ajodutola/FuelCellMonitorTeam-ECEN403/All_Russ_Docs/PCB Design.jpg

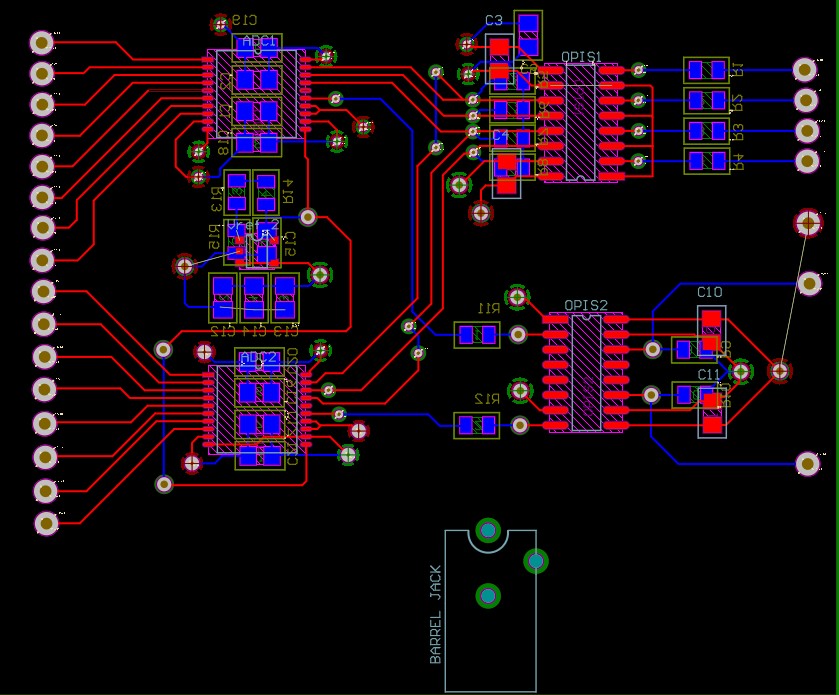
All_Russ_Docs/PCB Design.jpg
