ajodutola/FuelCellMonitorTeam-ECEN403/All_Russ_Docs/High Level Subsystem Schematic.jpg

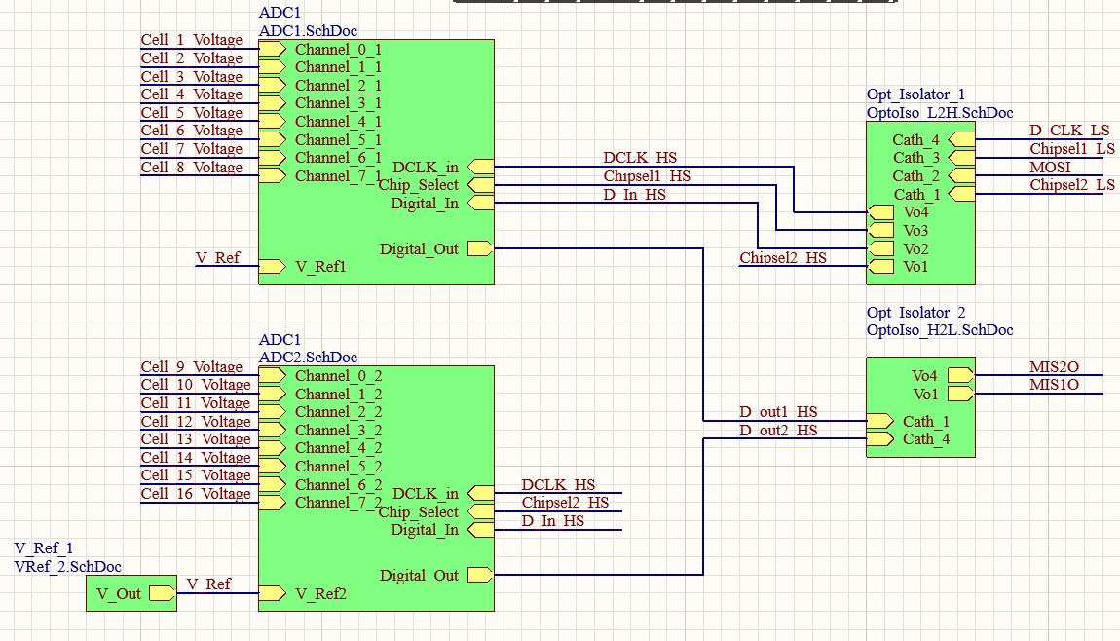
All_Russ_Docs/High Level Subsystem Schematic.jpg
