ajodutola/FuelCellMonitorTeam-ECEN403/All_Russ_Docs/Max into Processor is 14mA.docx

Max into Processor is 14mA.

Max input Voltage 5V.
