ajodutola/FuelCellMonitorTeam-ECEN403/Status Update 5-1.pdf

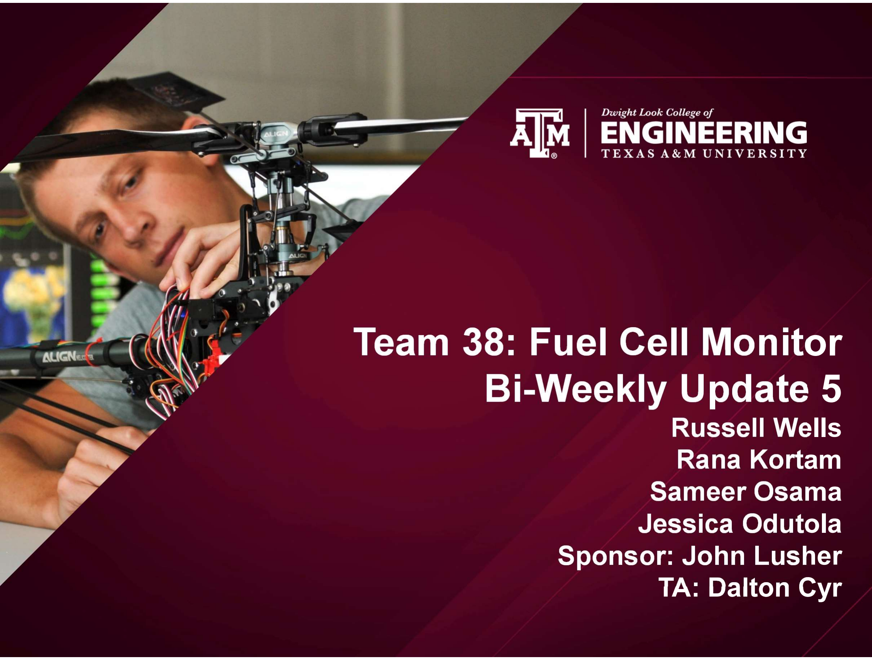
[picture p58: page 1]

# Team 38: Fuel Cell Monitor Bi-Weekly Update 5

### Russell Wells Rana Kortam Sameer Osama Jessica Odutola Sponsor: John Lusher TA: Dalton Cyr

# Project Summary

- Problem statement: A single fuel cell is an easy power source to monitor, but to achieve any level of real usable power

they must be connected in a stack. If only monitored as a whole, each cell would have to be tested individually to determine the issue. This causes longer down times and more technician wages


to trouble shoot.
- The Fuel Cell Monitor System will give the operator real time voltages of both the individual cells and stack. The voltages will be monitorable from an android based mobile app. In case of over or under voltage, the app will notify

the operator of not only the error but which cell has fallen or risen outside of expected ranges. Saving both time and money for repairs.

## Fuel Cell Monitor Integrated System Diagram

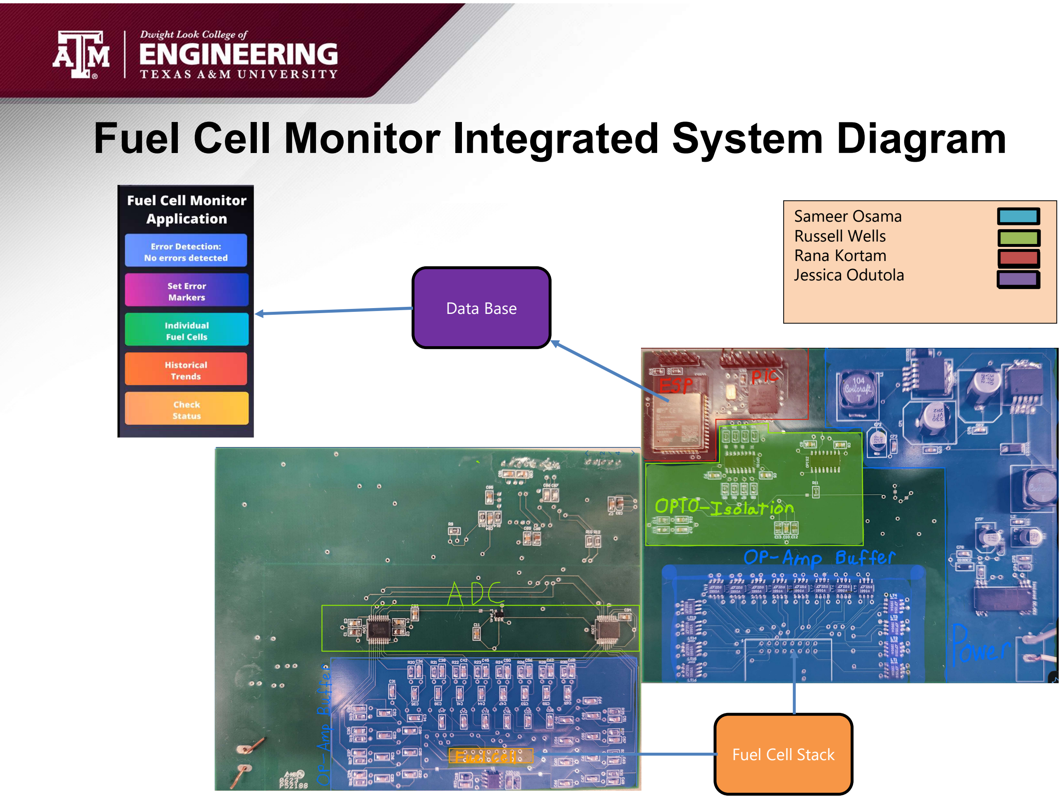
[picture p59: page 3]

Sameer Osama
Russell Wells
Rana Kortam
Jessica Odutola

Fuel Cell Stack

Data Base

# Project Timeline

Finalize Subsystems [Late January]

Power system issue resolved,
Burnt out Op-Amp was the
issues. SPI communication
validated.

PIC is not manipulating chip
select for each device. The
ADC’s do not recognize the
data being transmitted to
them.

Validate PCB and
start assembly
[February]

Debug and Integrate
[late February and
March]

Validation
[mid February through
late March]

Final Demo [late April]

Board is soldered and
ESP/PIC32 have been
successfully flashed.

# Sameer Osama

Accomplishments since Update | Ongoing progress/problems and plans until the next presentation
- N/A | handle twice the maximum voltage - Testing negative differential in buffer system
4 | 8 hrs of effort | - Ongoing: Testing if device can

-DC/DC converters output correct voltages from 0A – 1A
-Isolated DC/DC converter max current it can handle is .15A while still outputting the voltage required.

E-load measurements:

# Sameer Osama


# Russ Wells

Accomplishments since Update 4 11 Hours Worked | Ongoing progress/problems and plans until the next presentation
Validated Full Voltage Range. | Ongoing: -- Validating ADC operations. -- Update PCB Design as needed.

# Rana Kortam

Ongoing progress/problems and plans until the next presentation

Accomplishments since update 4

### 15 hrs of effort

Ongoing: Integrating with ADC; Clock and digital in pin are working correctly and were able to read voltage values from the Digital out pin. The Chip select doesn't work properly.
Future: Complete Integration with ADC and Database

Validating Full Voltage Range with Russ.

# Rana Kortam and Russ Wells

ADC voltage readings from cells

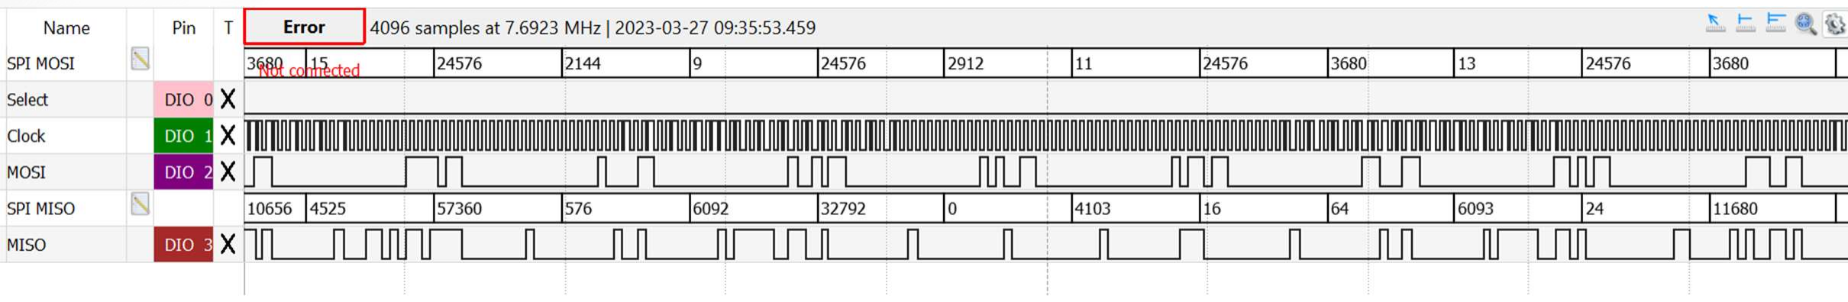
[picture p60: figure]

# Rana Kortam and Russ Wells

ADC voltage readings from cells

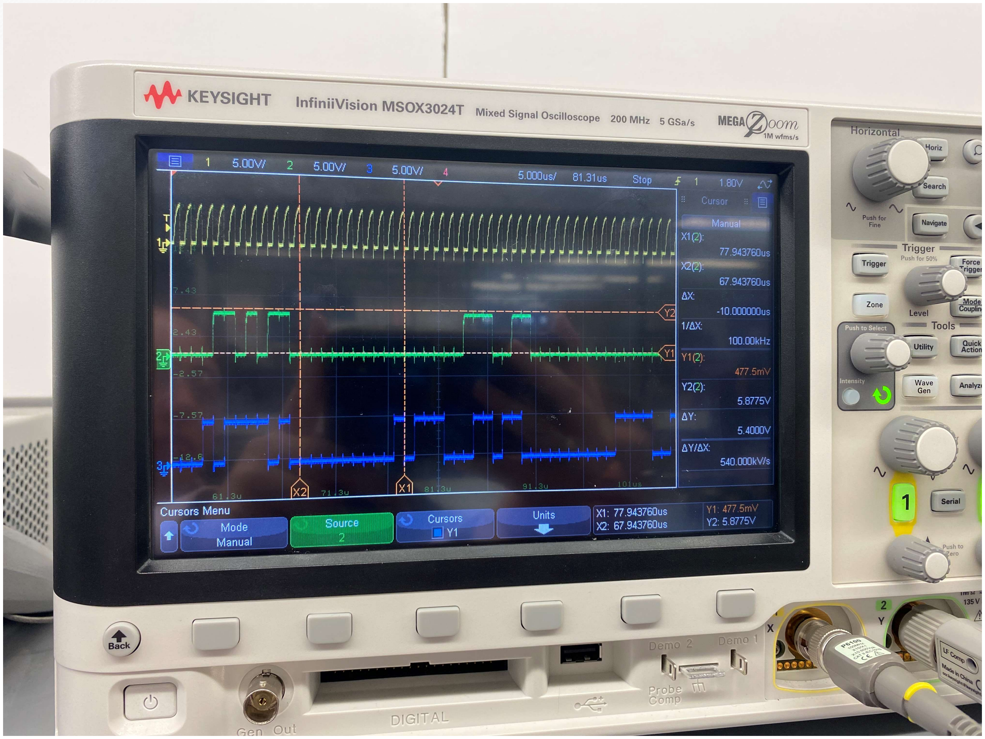
[picture p61: figure]

# Jessica Odutola

Accomplishments since update 4 | Ongoing progress/problems and plans until the next presentation
N/A | edge cases for App Subsystem - Future: Complete integration and validate integrated system
10 hrs of effort | - Ongoing: Integration with MCU; - Ongoing: Testing and validating

# Jessica Odutola

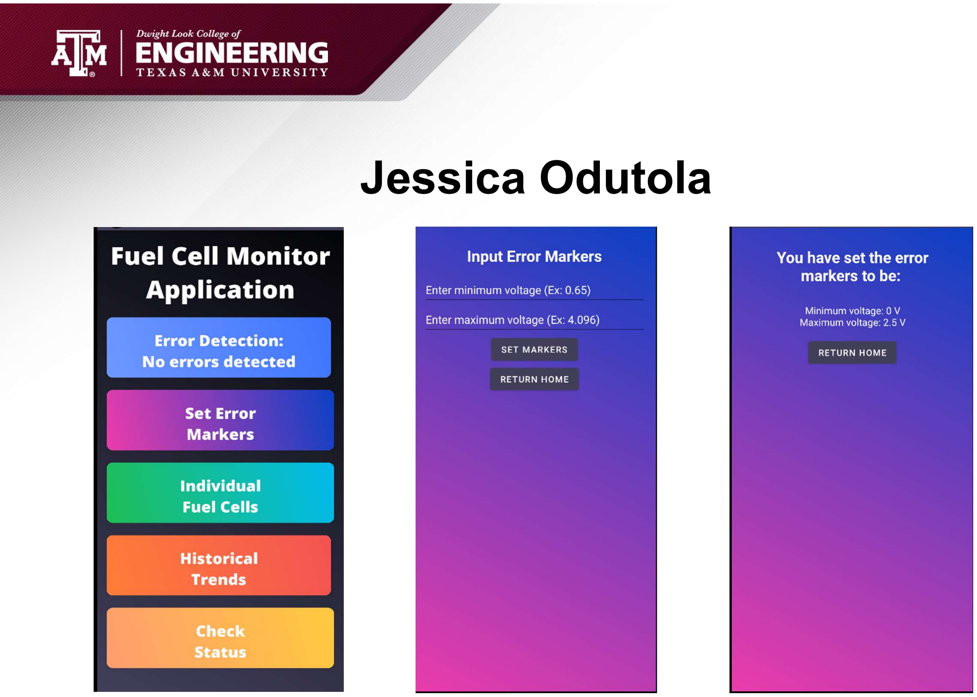
[picture p62: page 12]

## Execution Plan

| 1/17/2023 | 1/24/2023 | 1/31/2023 | 2/7/2023 | 2/14/2023 | 2/21/2023 | 2/28/2023 | 3/7/2023 | 3/14/2023 | 3/21/2023 | 3/28/2023 | 4/4/2023 | 4/11/2023 | 4/18/2023 | 4/25/2023 | DATE
TEAM DELIVERABLES
Solder and Test Power | | | | | | | | | | | | | | | | Completed
Solder and Test Signal Transfer | | | | | | | | | | | | | | | | In Progress
Solder and Test Micro Controllers | | | | | | | | | | | | | | | | Not Started
PCB/System redesign and order for Test Problems and Pactec Enclosure | | | | | | | | | | | | | | | | Behind Schedule

Full System Assembly and Testing
POWER SUBSYSTEM
Troubleshoot system
Order extra parts if need be INTERNAL SIGNAL SUBSYSTEM
Integrated PCB Design
Order Integrated PCB
MICRO CONTROLLER SUBSYSTEM
SPI communication with ADC
Review SPI communication with Dr. Lusher Integrate SPI with ADC
Order for Test Problems
APP SUBSYSTEM
App Reads Values from Database Integration with Microcontroller Full System Assembly and Testing

## Validation Plan

| Test Name | Success Criteria | Methodology | Status | Responsible Engineer(s) | Notes Paragraph #
| Mass | Mass of the fuel cell monitor shall be less than or equal to 0.25 kilograms 3.1.1.1 | scale | Untested | Rana Measure the fuel cell monitor with digital | Cells were tested at
| Read full voltage Range | voltages to the database from 0 to 4.096 V 3.2.1.1 | Apply sustained negative voltage | Passed | Russell Device is capable of measuring and passing | 0V, 1V, 2V, and 4.096V and 5Volts.
3.2.4.2 Discontinuous cell | | Device is capable of handling up to twice the maximum measurable voltage input without damage to system | a single cell input and check functionality. | Untested | Sameer Apply voltages at least 8.192 Volts across
| General Error Alerts | App is able to correctly indicate which fuel cell is Low/High and Alerts the User of the situation Via the App. 4.3.1 | scale | Untested | Jessica Measure the fuel cell monitor with digital
| User Specified Error Markers | App is capable of successfully changing the criteria for alerts 4.3.2 | voltage range, apply a voltage outside of the range to one of the cells and monitor the app for the error alert. | Untested | Jessica Use the app the manipulate the fuel cell
| Power Outage Restart | Device should power up, reboot, and continue operation after full power disconnect 5.1.1.1 | (Allow capacitors to dissipate) and reconnect power. | Untested | Rana Disconnect power source for 30 seconds
| System Loop Functionality | by the device, reported to the database, and displayed on the app. 5.1.1.1 | both the database and is displayed on the app. A voltage is applied to the fuel cell input, read cell input and ensure the data appears in | Untested | Rana Apply a voltage of 2.048 volts to the first

# Thank you! Any questions?
