ajodutola/FuelCellMonitorTeam-ECEN403/All_Russ_Docs/Final Presentation PDF.pdf

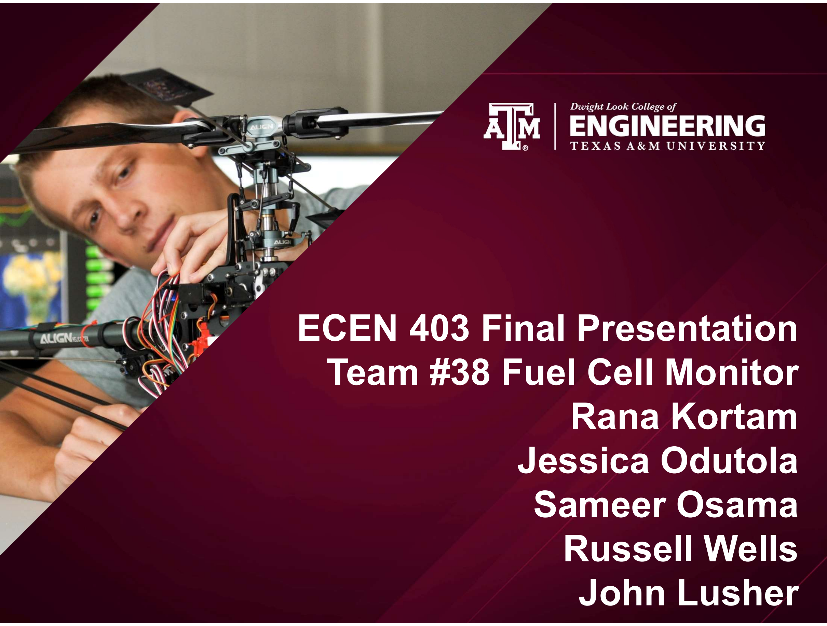
[picture p78: page 1]

# ECEN 403 Final Presentation Team #38 Fuel Cell Monitor Rana Kortam Jessica Odutola Sameer Osama Russell Wells John Lusher

# Project description

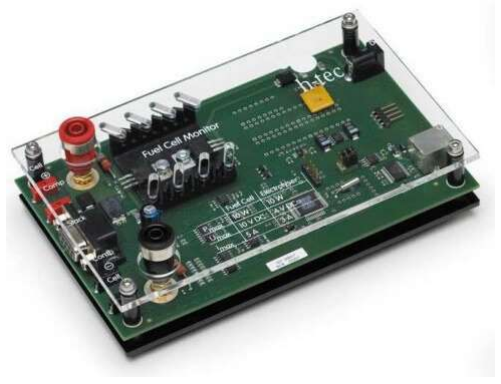
[picture p79: figure]

- Problem statement: A single fuel cell is an easy power source to monitor, but to achieve any level of real usable power they must be connected in a stack. The goal of this project is to design a monitor that displays individual cell voltages within a stack and warns the user of cell abnormalities as well as which cell

requires maintenance or attention.

# Diagram of subsystems and interface

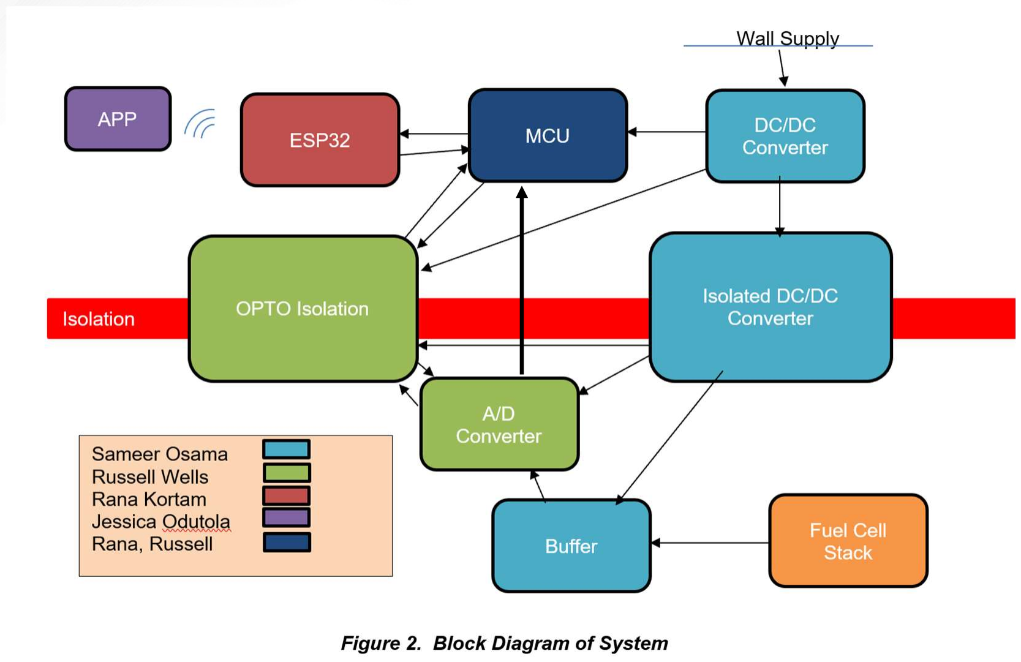
[picture p80: figure]

# 403 Deliverables (Power Supply)

# - Design PCB in Altium - Order PCB and solder components - Test output voltages

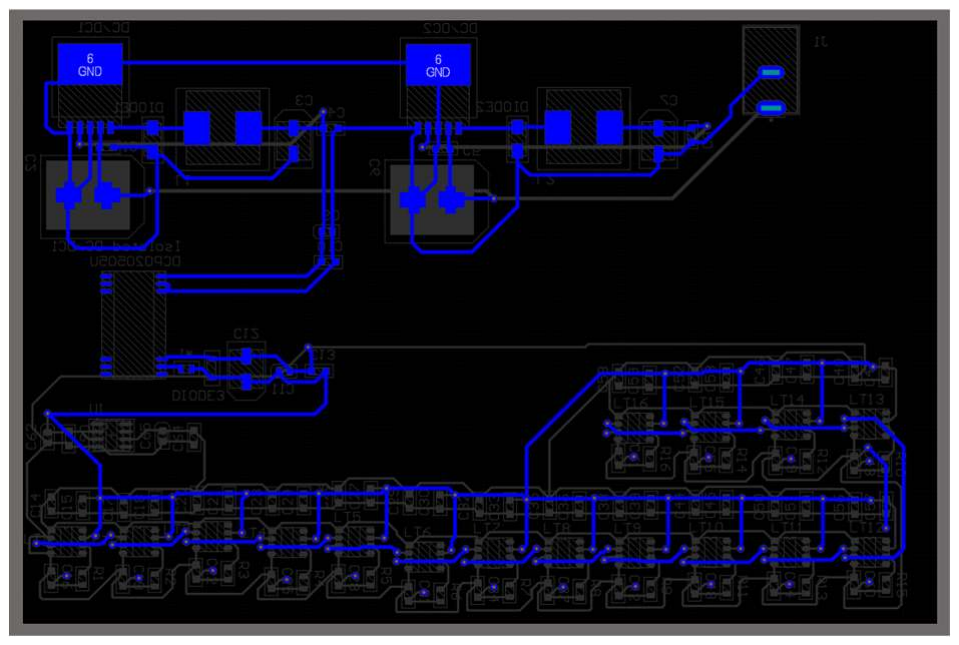
[picture p81: figure]
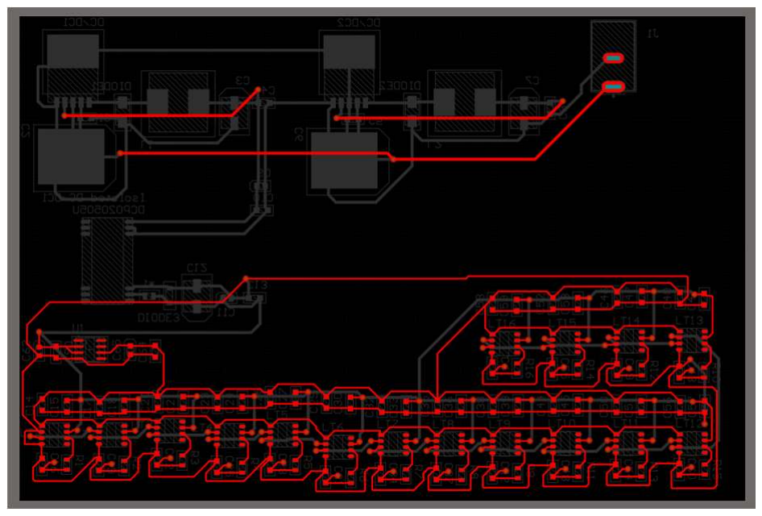
[picture p82: figure]

Top Layer | Bottom Layer

# Challenges (Power Supply)

# - Learning how to make schematics and footprints - Using a new software (Altium) - Figuring out what specific parts to order

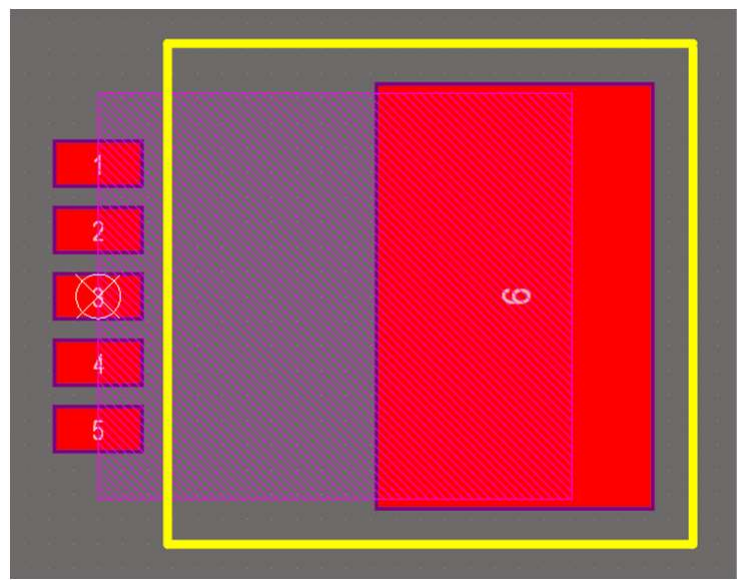
[picture p83: figure]
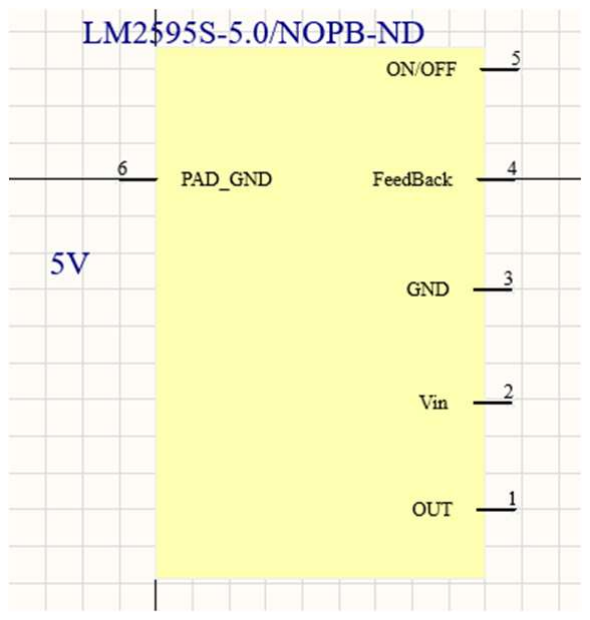
[picture p84: figure]

- Create PCB Design.

# - Create Breadboard Test Circuit

- Confirm Isolator Circuit’s Ability To Pass Digital Information. Confirm Isolator Circuit’s Ability to Control ADC.

# Internal Data Transfer and Manipulation Deliverables

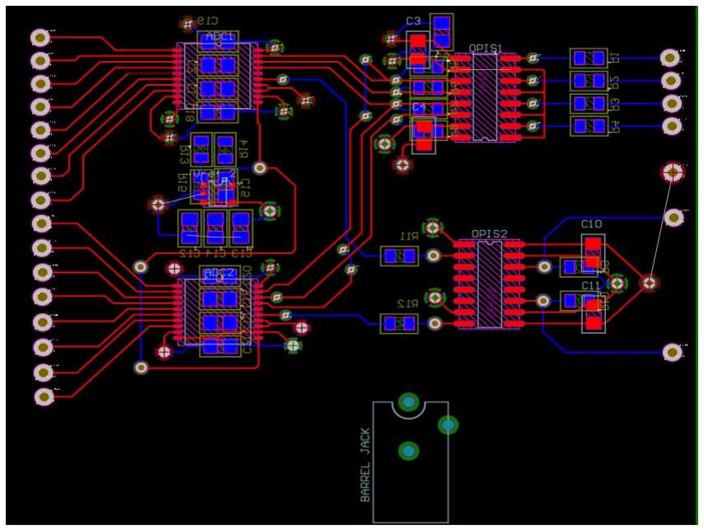
[picture p85: figure]

# CHALLENGES 1. Isolator Distorts Digital Signal 2. Switching Speed of isolator is much lower than anticipated 3. Learning To code with Arduino and use SPI

Library.

# SOLUTIONS 1. Reduce Clock Frequency from 2MHz to 125kHz (Ongoing) 2. Same solution as 1 but the frequency is slightly higher than 1/24th the capability of

the ADC.

# 3. Continuing to learn from

Arduino website and forums.

# Internal Data Transfer and Manipulation

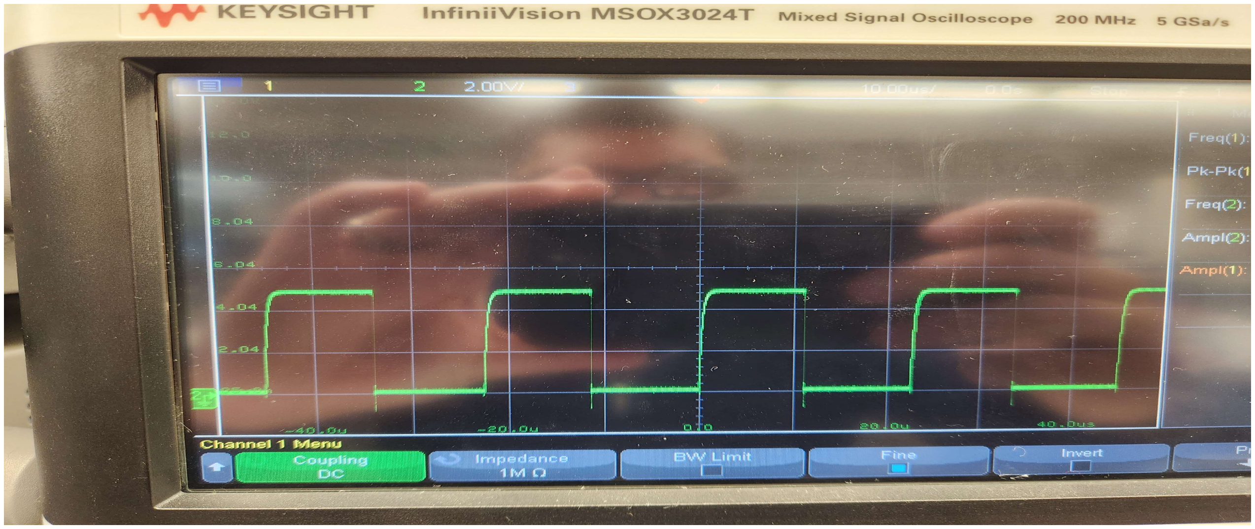
[picture p86: figure]

# ESP32

# 403 Deliverables

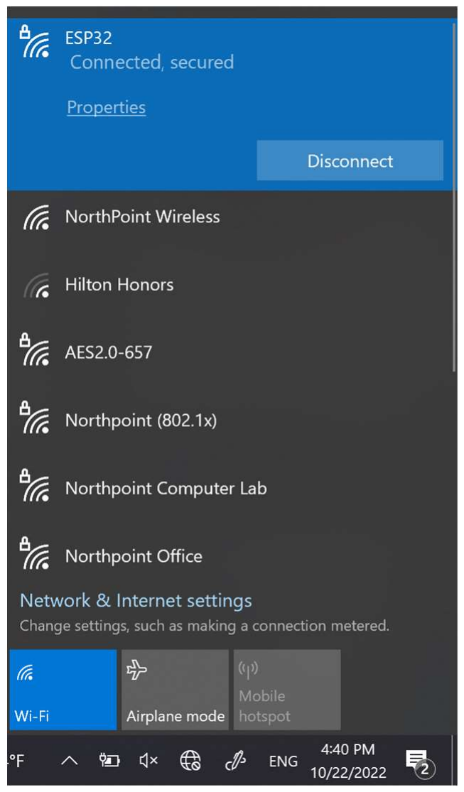
[picture p87: figure]

# - ESP32 to connect to WiFi - UART communication for ESP32 - Connect ESP32 to database Challenges - Learning the ESP-IDE - Connection to database

# ESP32

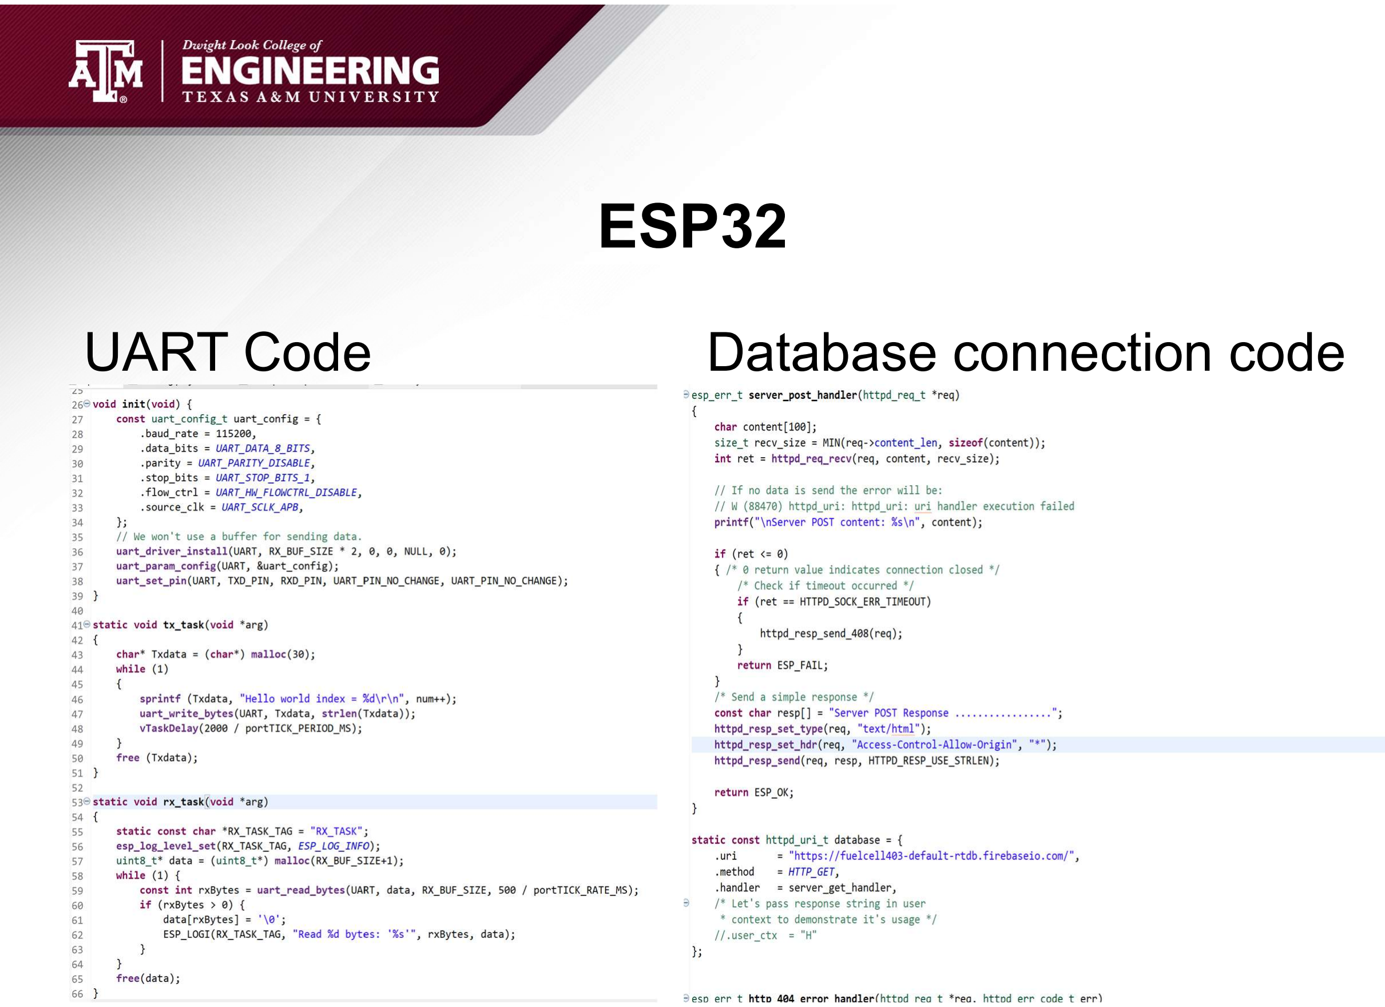
[picture p88: page 9]

UART Code | Database connection code

# PIC32

# 403 Deliverables

# - UART communication - A/D converter code - Array of fuel-cell voltages Challenges - Learning MPLAB IDE - Fried the PIC32 chip

# PIC32

AD Converter Code | UART Code

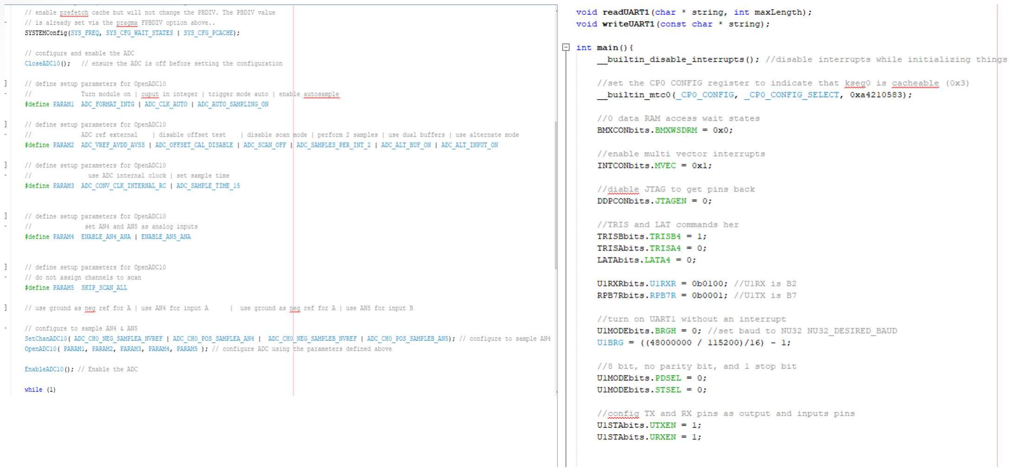
[picture p89: figure]

# Android Application

# 403 Deliverables - Complete Layout of Android Application - Database Storage and Connection to App - Alert functionality for user Challenges - Database Connection

# Android Application

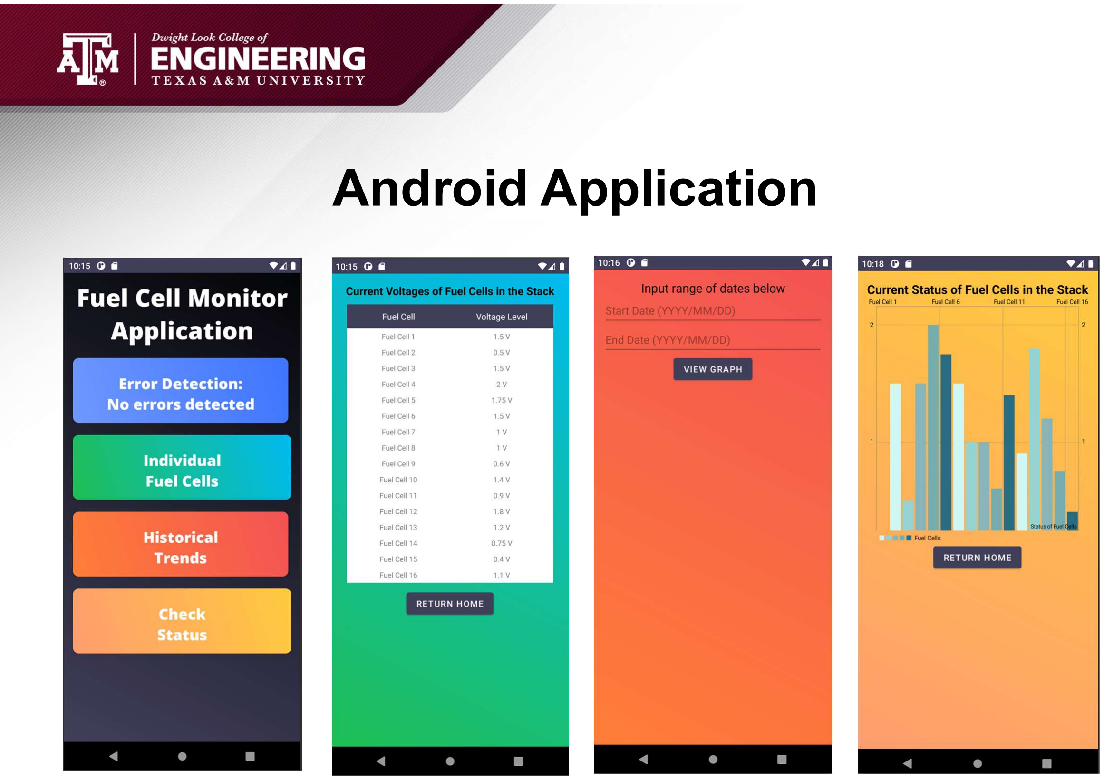
[picture p90: page 13]

# Execution and Validation Status

9/5/2022 | 9/12/2022 | 9/19/2022 | 9/26/2022 | 10/3/2022 | 10/10/2022 | 10/17/2022 | 10/24/2022 | 10/31/2022 | 11/7/2022 | 11/14/2022 | 11/21/2022 | 11/28/2022 | DATE TEAM DELIVERABLES Understand Project Problem
Project design Overview | Completed Divide Into Subsystems | In Progress ConOps Report | Not Started Create Major Parts List | Behind Schedule

FSR, ICD Report Midterm Presentation Order Major Parts

Status Update Presentation Final Presentation
Final Demo
Final Report POWER SUBSYSTEM

Determine IC Components
Design Schematics
Order IC components
Create PCB footprints in Altium Create PCB design in Altium Make Gerber files and send to FEDC Test components on circuit board INTERNAL SIGNAL SUBSYSTEM
Determine IC Components
Design System
Order Components Create PCB Schematic Assemble and Test Demo Create PCB Design Order PCB MICRO CONTROLLER SUBSYSTEM

Determine Microcontrollers in use Learn IDE to code microcontroller Implement "Hello World" on ESP32 WiFi connection on ESP32 UART on ESP32 UART on PIC32 Array code for PIC32 AD Converter code Connect ESP32 to database APP SUBSYSTEM

App Displays "Hello World" App Displays Home Page
App Displays all pages needed AWS Database Created

Tables Populated in Database Connect Database to App
App Sends Alerts to Users
App Works with Test Data WiFi Connection with Microcontroller

# Execution and Validation Status

Paragraph # | Test Name | Success Criteria | Methodology | Status | Responsible Engineer(s)
3.2.4.2 | Power Devices On PCB | PCB transfers power without overheating or burnout | Power Board and watch, smell, listen | Untested | Russell, Sameer
3.2.1.1 | Internal signal voltage range | System can properly handle the specified voltages with minimal difference between tests. | Introduce voltages of 0-4V and measure output signals | FAIL | Russell
3.2.1.1 | Differential voltage tests | Pass a differential voltage through the Opamp buffer and receive the proper digital signal from the optoisolator | Introduce a range of voltages including edge cases and ensure proper output | Untested | Russell, Sameer
3.2.4.4 | Android application graphical functionality | Application can properly display accurate voltage levels to user. | Use application on android device and verify volatages are accurately displayed | Tested | Jessica
3.2.4.4 | Android Application alarm functionality | Application send alarm to user when voltage goes above or below ranges | Add set points to app and introduce alarm level voltages | Untested | Jessica
3.2.4.2 | Power system functionality test | Power is applied from wall outlet and proper power transfer is read at outputs | Apply power to system and read voltage output at device trace | Untested | Sameer
3.2.4.1 | Opamp system functionality test | Differential voltages are passed to the opamp and expected voltage is seen on the output | Power opamps and apply varrying differential voltages and read output voltage | Untested | Sameer
N/A | PIC32 Microcontroller functionality test | The code for recieving the voltage signal for data acquisition | PCB board and coding on IDE | In progress | Rana
N/A | ESP32 Microcontroller functionality test | The code for communicating with the application | PCB board and coding on IDE | Tested | Rana

# Remaining Tasks

# - Complete testing of internal signal system - Complete Microcontroller/processor PCB design - Integrate All subsystems onto a single

PCB.

# - Final Testing and Validation of Completed

Internal System.

# - Purchase system enclosure and

assemble.
