ajodutola/FuelCellMonitorTeam-ECEN403/All_Russ_Docs/Update Presentation.pptx

Team: Project Title

Needs Analysis Problem Statement Design Proposal | Subsystem Development - Prototype

System Block Diagram and description

## Project name: Fuel Cell Monitor Team members: Rana Kortam Jessica Odutola Sameer Osama Russell Wells Sponsor: John Lusher

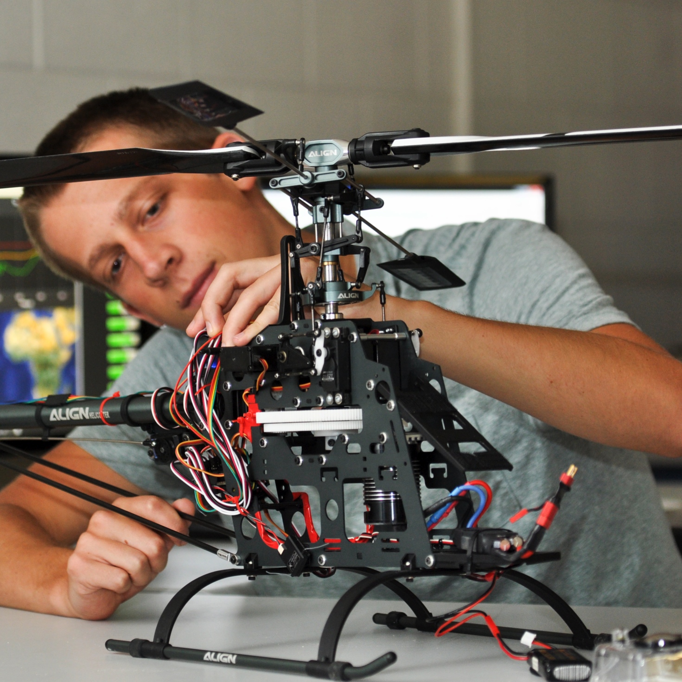
[picture p108: figure]

## Slide 3

Team: Project Title

Copy of your schedule with identification of what is completed vs pending

## Slide 4

<Subsystem(s)> Team Member1

Accomplishments since the last presentation <XX> hrs | Ongoing progress/problems and plans until the next presentation

Subsystem Picture, Sketch or Graph (1 per team member)

## Slide 5

<Internal Signal Transfer and Manipulation Subsystem> Team Member2

Accomplishments since the last presentation <30> hrs | Ongoing progress/problems and plans until the next presentation
Subsystem design is complete and has been successfully simulated All subsystem components have been ordered.

Subsystem Picture, Sketch or Graph (1 per team member)

## Slide 6

<Subsystem(s)> Team Member3

Accomplishments since the last presentation <XX> hrs | Ongoing progress/problems and plans until the next presentation

Subsystem Picture, Sketch or Graph (1 per team member)

## Slide 7

<Subsystem(s)> Team Member4

Accomplishments since the last presentation <XX> hrs | Ongoing progress/problems and plans until the next presentation

Subsystem Picture, Sketch or Graph (1 per team member)
