ajodutola/FuelCellMonitorTeam-ECEN403/All_Russ_Docs/20221130_115714.jpg

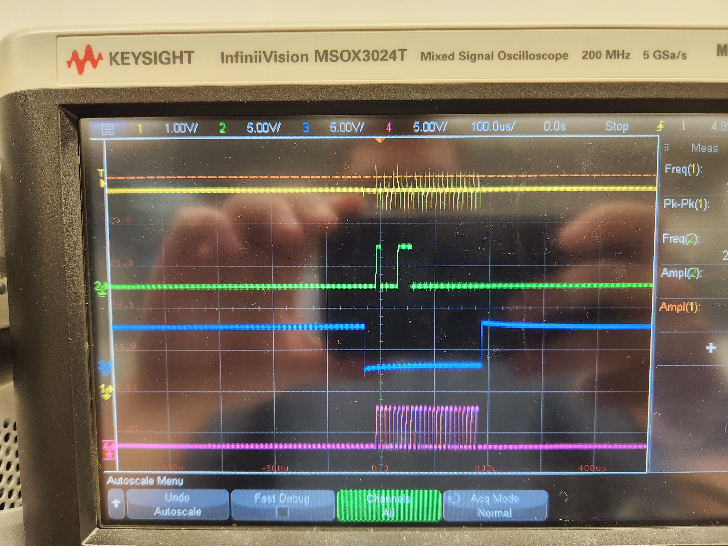
All_Russ_Docs/20221130_115714.jpg
