ajodutola/FuelCellMonitorTeam-ECEN403/All_Russ_Docs/ADC screen shot.jpg

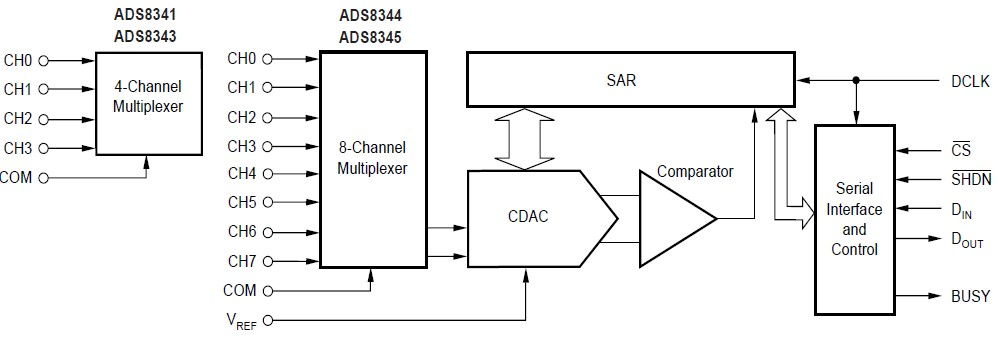
All_Russ_Docs/ADC screen shot.jpg
