ajodutola/FuelCellMonitorTeam-ECEN403/All_Russ_Docs/ADC's.jpg

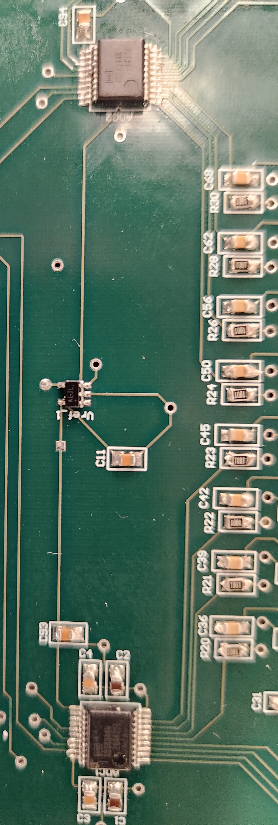
All_Russ_Docs/ADC's.jpg
