ajodutola/FuelCellMonitorTeam-ECEN403/All_Russ_Docs/Board Pic.png

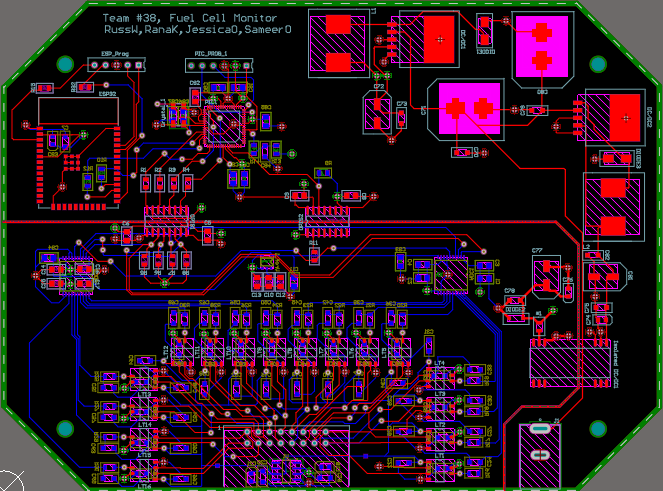
All_Russ_Docs/Board Pic.png
