ajodutola/FuelCellMonitorTeam-ECEN403/All_Russ_Docs/ESP WIFI Connected.jpg

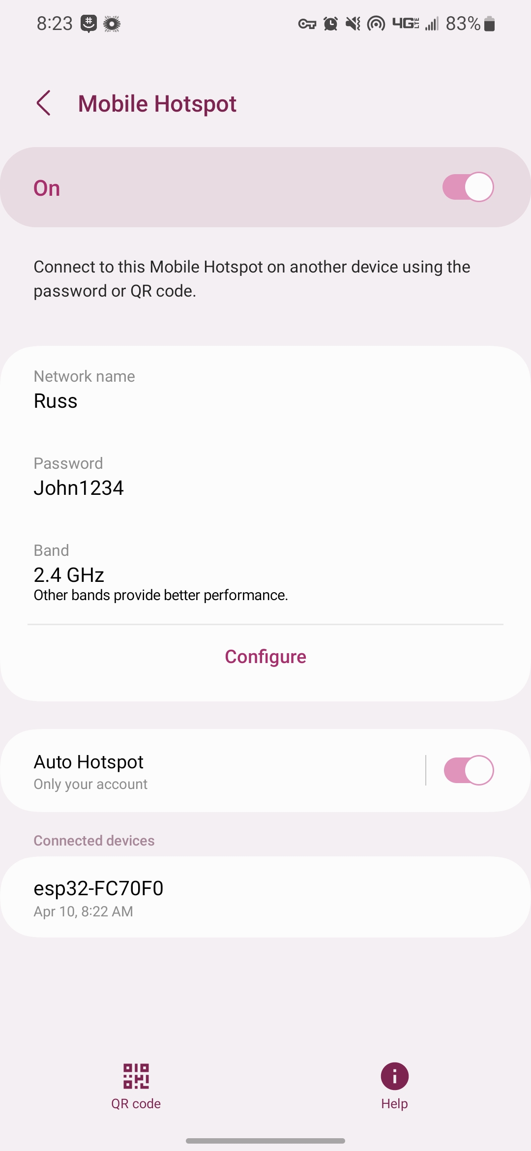
All_Russ_Docs/ESP WIFI Connected.jpg
