ajodutola/FuelCellMonitorTeam-ECEN403/All_Russ_Docs/FCM_02_03_2023.jpg

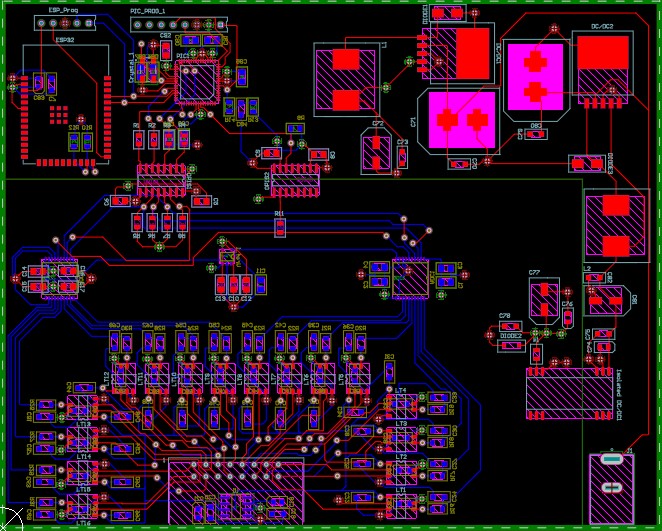
All_Russ_Docs/FCM_02_03_2023.jpg
