ajodutola/FuelCellMonitorTeam-ECEN403/All_Russ_Docs/op amp Vref.jpg

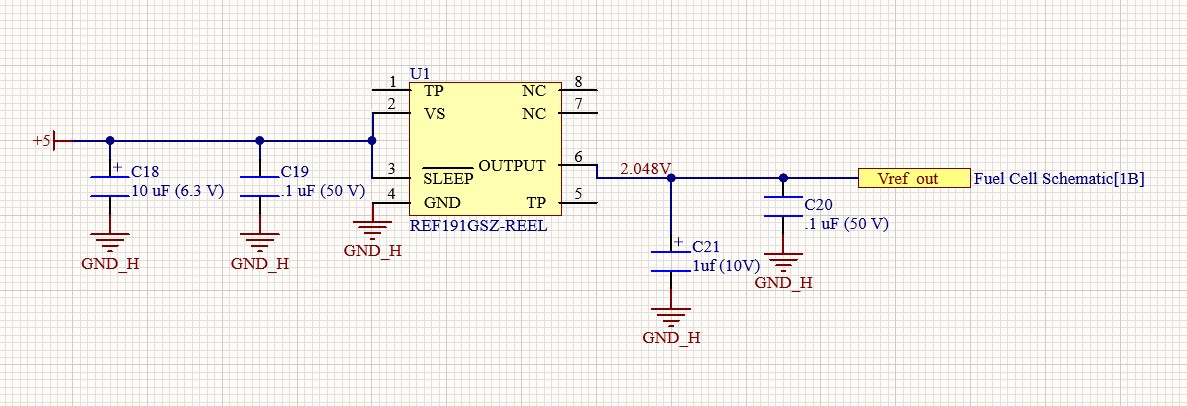
All_Russ_Docs/op amp Vref.jpg
