ajodutola/FuelCellMonitorTeam-ECEN403/All_Russ_Docs/Opto Isolators.jpg

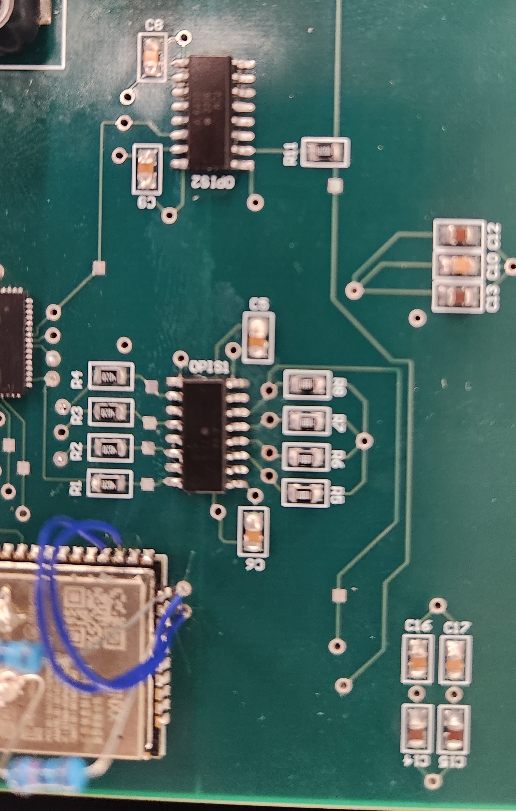
All_Russ_Docs/Opto Isolators.jpg
