ajodutola/FuelCellMonitorTeam-ECEN403/All_Russ_Docs/Opto screen shot.jpg

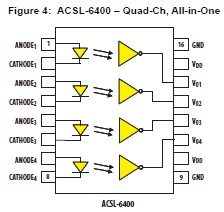
All_Russ_Docs/Opto screen shot.jpg
