ajodutola/FuelCellMonitorTeam-ECEN403/All_Russ_Docs/Recieved DATA.jpg

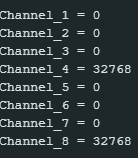
All_Russ_Docs/Recieved DATA.jpg
