ajodutola/FuelCellMonitorTeam-ECEN403/All_Russ_Docs/Update Present Picture.jpg

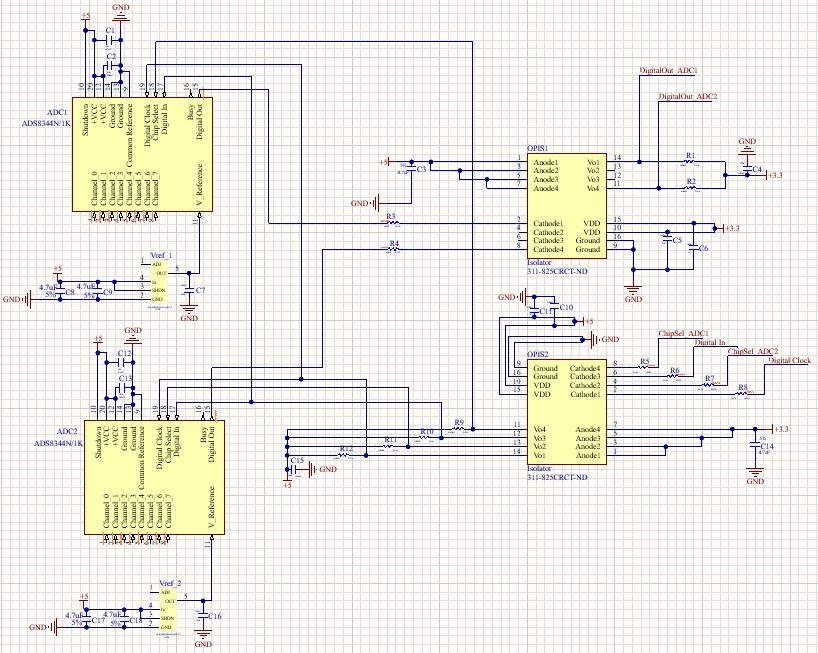
All_Russ_Docs/Update Present Picture.jpg
