ajodutola/FuelCellMonitorTeam-ECEN403/All_Russ_Docs/Project Purchasing Spreadsheet (1).xlsx

Order Date | Part Number | Item Name | Location to Buy From | Cost per Part | Quantity | Total Cost | Item Description
2022-09-21 | 296-41197-1-ND - Cut Tape (CT) | ADS8344N/1K | https://www.digikey.com/en/products/detail/texas-instruments/ADS8344N-1K/1689698 | $18.10 | 2 | $36.20 | Analog to digital converter,
2022-09-21 | 516-2917-1-ND | ACSL-6400-50TE | https://www.digikey.com/en/products/detail/broadcom-limited/ACSL-6400-50TE/1234506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 | $10.50 | 2 | $21.00 | Opto Isolator 1/3 Bi directional
2022-09-21 |  |  |  |  |  | $0.00
2022-09-21 | 102-3430-ND | SWI12-12-N-P5 | https://www.digikey.com/en/products/detail/cui-inc/SWI12-12-N-P5/5287239 | $13.31 | 1 | $13.31 | AC/DC WALL MOUNT ADAPTER 12V 12W
2022-09-21 |  | LM2595S-5.0/NOPB | https://www.ti.com/product/LM2595/part-details/LM2595S-5.0/NOPB | $4.27 | 2 | $8.53 | Step down (buck) voltage regulator (5V)
2022-09-21 |  | LM2595S-3.3/NOPB | https://www.ti.com/product/LM2595/part-details/LM2595S-3.3/NOPB | $4.27 | 2 | $8.53 | Step down (buck) voltage regulator (3.3V)
2022-09-21 |  | DCP020505U | https://www.ti.com/product/DCP020505/part-details/DCP020505U | 14.641 | 2 | $29.28 | Isolated DC/DC converter
2022-09-21 |  | LT1990ACS8#PBF | https://www.mouser.com/ProductDetail/Analog-Devices/LT1990ACS8PBF?qs=ytflclh7QUW%2F%2FcFnA3IxKQ%3D%3D | 5.95 | 18 | $107.10 | IC OPAMP DIFF 1 CIRCUIT 8SO
 |  |  |  |  |  | $0.00
2022-09-21 |  | ESP-WROOM-32 ESP32 ESP-32S | https://www.amazon.com/HiLetgo-ESP-WROOM-32-Development-Microcontroller-Integrated/dp/B0718T232Zcrid=1R1B9HX8ZY3PG&keywords=PIC32&qid=1665013470&qu=eyJxc2MiOi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 | $10.99 | 1 | $10.99 | ESP32 is a feature-rich MCU with integrated Wi-Fi and Bluetooth connectivity for a wide-range of applications.
2022-09-21 |  | PIC32MX230F256B-I/SP PIC/DSPIC | https://www.amazon.com/MICROCHIP-PIC32MX230F256B-I-SP-Microcontroller-Microcontrollers/dp/B07FQ3TLQ7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 | $14.22 | 1 | $14.22 | MIPS32® M4K™ Automotive, AEC-Q100, PIC® XLP™ 32MX Microcontroller IC 32-Bit Single-Core 72MHz 256KB (256K x 8) FLASH 28-QFN-S (6x6)
 |  |  |  |  |  | $0.00
 |  |  |  |  |  | $0.00
 |  |  |  |  |  | $0.00
 |  |  |  |  |  | $0.00
 |  |  |  |  |  | $0.00
 |  |  |  |  |  | $0.00
 |  |  |  |  | Order Total Cost: | $249.17
 |  |  |  |  | Spent to date | $249.17
