ajodutola/FuelCellMonitorTeam-ECEN403/All_Russ_Docs/Team38_Project Purchasing Spreadsheet (1) (3) (1).xlsx

Sheet: Sheet1
Order Date | Part Number | Item Name | Location to Buy From | Cost per Part | Quantity | Total Cost | Item Description
2022-09-21 | 296-41197-1-ND - Cut Tape (CT) | ADS8344N/1K | https://www.digikey.com/en/products/detail/texas-instruments/ADS8344N-1K/1689698 | $18.10 | 2 | $36.20 | Analog to digital converter,
2022-09-21 | 516-2917-1-ND | ACSL-6400-50TE | https://www.digikey.com/en/products/detail/broadcom-limited/ACSL-6400-50TE/1234506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 | $10.50 | 2 | $21.00 | Opto Isolator 1/3 Bi directional
2022-09-21 |  |  |  |  |  | $0.00
2022-09-21 | 102-3430-ND | SWI12-12-N-P5 | https://www.digikey.com/en/products/detail/cui-inc/SWI12-12-N-P5/5287239 | $13.31 | 1 | $13.31 | AC/DC WALL MOUNT ADAPTER 12V 12W
2022-09-21 |  | LM2595S-5.0/NOPB | https://www.ti.com/product/LM2595/part-details/LM2595S-5.0/NOPB | $4.27 | 2 | $8.53 | Step down (buck) voltage regulator (5V)
2022-09-21 |  | LM2595S-3.3/NOPB | https://www.ti.com/product/LM2595/part-details/LM2595S-3.3/NOPB | $4.27 | 2 | $8.53 | Step down (buck) voltage regulator (3.3V)
2022-09-21 |  | DCP020505U | https://www.ti.com/product/DCP020505/part-details/DCP020505U | 14.641 | 2 | $29.28 | Isolated DC/DC converter
2022-09-21 |  | LT1990ACS8#PBF | https://www.mouser.com/ProductDetail/Analog-Devices/LT1990ACS8PBF?qs=ytflclh7QUW%2F%2FcFnA3IxKQ%3D%3D | 5.95 | 18 | $107.10 | IC OPAMP DIFF 1 CIRCUIT 8SO
 |  |  |  |  |  | $0.00
2022-09-21 |  | ESP-WROOM-32 ESP32 ESP-32S | https://www.amazon.com/MICROCHIP-PIC32MX230F256B-I-SP-Microcontroller-Microcontrollers/dp/B07FQ3TLQ7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 | $10.99 | 1 | $10.99 | ESP32 is a feature-rich MCU with integrated Wi-Fi and Bluetooth connectivity for a wide-range of applications.
2022-09-21 |  | PIC32MX230F256B-I/SP PIC/DSPIC | https://www.amazon.com/MICROCHIP-PIC32MX230F256B-I-SP-Microcontroller-Microcontrollers/dp/B07FQ3TLQ7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 | $14.22 | 1 | $14.22 | MIPS32® M4K™ Automotive, AEC-Q100, PIC® XLP™ 32MX Microcontroller IC 32-Bit Single-Core 72MHz 256KB (256K x 8) FLASH 28-QFN-S (6x6)
 |  |  |  |  |  | $0.00
2022-11-18 |  | PCB | Advanced PCB | $33 | 1 | $33.00 | Two layer board
 |  |  |  |  |  | $0.00
 |  |  |  |  |  | $0.00
2023-01-30 |  |  |  |  |  | $0.00
 |  |  |  |  |  | $0.00
 |  |  |  |  |  | $0.00
 |  |  |  |  |  | $0.00
 |  |  |  |  |  | $0.00
 |  |  |  |  |  | $0.00
 |  |  |  |  |  | $0.00
 |  |  |  |  |  | $0.00
 |  |  |  |  | Order Total Cost: | $282.17
 |  |  |  |  | Spent to date | $282.17
 |  |  |  |  | Budget Remaining | $110.33

Sheet: Order Form
Order Date | Part Number | Item Name | Location to Buy From | Cost per Part | Quantity | Total Cost | Item Description | Current Budget
 |  |  |  |  |  |  |  | 110.334
 |  |  |  |  |  |  |  |  | https://www.digikey.com/short/4p7w2338
2023-01-30 | 3M11930-ND | 30316-5002HB | https://www.digikey.com/en/products/detail/3m/30316-5002HB/1237396 | $1.55 | 2 | $3.10
2023-01-31 | 3M156034-ND | D89116-0131HK | https://www.digikey.com/en/products/detail/3m/D89116-0131HK/1886294 | $2.00 | 2 | $4.00
2023-02-01 | CTX834CT-ND | 405C11A16M00000 | https://www.digikey.com/en/products/detail/cts-frequency-controls/405C11A16M00000/2292737 | $0.96 | 2 | $1.92
2023-02-02 | 399-C0805C100F5GACAUTOCT-ND | C0805C100F5GACAUTO | https://www.digikey.com/en/products/detail/kemet/C0805C100F5GACAUTO/10482945 | $0.74 | 4 | $2.96
2023-02-03 | MAX6037BAUK41+TCT-ND | MAX6037BAUK41+T | https://www.digikey.com/en/products/detail/analog-devices-inc-maxim-integrated/MAX6037BAUK41-T/1515473 | $4.11 | 2 | $8.22
2023-02-04 | PIC32MX470F512H-120/MR-ND | PIC32MX470F512H-120/MR | https://www.digikey.com/en/products/detail/microchip-technology/PIC32MX470F512H-120-MR/5305183 | $9.78 | 2 | $19.56
2023-02-05 | 296-41197-1-ND | ADS8344N/1K | https://www.digikey.com/en/products/detail/texas-instruments/ADS8344N-1K/1689698 | $18.10 | 2 | $36.20
2023-02-06 | 399-15694-1-ND | C0805X106J8RAC7800 | https://www.digikey.com/en/products/detail/kemet/C0805X106J8RAC7800/7427524 | $0.94 | 5 | $4.70
2023-02-07 | REF191GSZ-REELCT-ND | REF191GSZ-REEL | https://www.digikey.com/en/products/detail/analog-devices-inc/REF191GSZ-REEL/994506 | $5.06 | 1 | $5.06
 |  |  |  |  | Order Total Cost: | $85.72
 |  |  |  |  | Spent to date | $367.89
 |  |  |  |  | Budget Remaining | $24.61
2023-03-31 | 399-C0805C104J4RAC7800CT-ND | C0805C104J4RAC7800 | https://www.digikey.com/en/products/detail/kemet/C0805C104J4RAC7800/2211736 | $0.37 | 15 | $5.59
2023-03-31 | 1965-ESP32-WROOM-32D-N8TR-ND | ESP32-WROOM-32D-N8 | https://www.digikey.com/en/products/detail/espressif-systems/ESP32-WROOM-32D-N8/9381717 | 4.35 | 1 | $4.35
2023-03-31 | YAG1321CT-ND | RC0805FR-071KP | https://www.digikey.com/en/products/detail/yageo/RC0805FR-071KP/4935336 | 0.063 | 30 | $1.89
2023-03-31 | 516-2917-1-ND | ACSL-6400-50TE | https://www.digikey.com/en/products/detail/broadcom-limited/ACSL-6400-50TE/1234506 | 8.9 | 2 | $17.80
2023-03-31 | YAG4897CT-ND | RT0805BRD07402RL | https://www.digikey.com/en/products/detail/yageo/RT0805BRD07402RL/1075881 | 0.272 | 10 | $2.72
2023-03-31 | 13-RC0805FR-1010KLCT-ND | RC0805FR-1010KL | https://www.digikey.com/en/products/detail/yageo/RC0805FR-1010KL/13694110 | 0.033 | 10 | $0.33
2023-03-31 | YAG1979CT-ND | RT0805BRD07820RL | https://www.digikey.com/en/products/detail/yageo/RT0805BRD07820RL/1076055 | 0.272 | 10 | $2.72
2023-03-31 | 399-C0805C100J5RACAUTOCT-ND | C0805C100J5RACAUTO | https://www.digikey.com/en/products/detail/kemet/C0805C100J5RACAUTO/16798115 | 0.16 | 4 | $0.64
2023-03-31 | 399-11939-1-ND | C0805C106K3PAC7800 | https://www.digikey.com/en/products/detail/kemet/C0805C106K3PAC7800/5267604 | 0.27 | 3 | $0.81
2023-03-31 | 399-17618-1-ND | C0805C104K6RAC7800 | https://www.digikey.com/en/products/detail/kemet/C0805C104K6RAC7800/8572453 | 0.44 | 4 | $1.76
2023-03-31 | LM2595S-5.0/NOPB-ND | LM2595S-5.0/NOPB | https://www.digikey.com/en/products/detail/texas-instruments/LM2595S-5-0-NOPB/333228 | 5.93 | 1 | $5.93
2023-03-31 | LM2595S-3.3/NOPB-ND | LM2595S-3.3/NOPB | https://www.digikey.com/en/products/detail/texas-instruments/LM2595S-3-3-NOPB/363698 | 5.93 | 1 | $5.93
2023-03-31 | P124823CT-ND (330uf) | EEE-FT1V331GV | https://www.digikey.com/en/products/detail/panasonic-electronic-components/EEE-FT1V331GV/10290486 | 1.84 | 2 | $3.68
2023-03-31 | 1276-1003-1-ND(.1 uf) | CL21B104KBCNNNC | https://www.digikey.com/en/products/detail/samsung-electro-mechanics/CL21B104KBCNNNC/3886661 | 0.1 | 60 | $6.00
2023-03-31 | B340AE-13DICT-ND | B340AE-13 | https://www.digikey.com/en/products/detail/diodes-incorporated/B340AE-13/7352831 | 0.38 | 2 | $0.76
2023-03-31 | 2457-MSS1278-104MLD-ND | MSS1278-104MLD(inductor) | https://www.digikey.com/en/products/detail/coilcraft/MSS1278-104MLD/15794243 | 2.86 | 2 | $5.72
2023-03-31 | P15078CT-ND(220uf) | EEE-FT0J221AR | https://www.digikey.com/en/products/detail/panasonic-electronic-components/EEE-FT0J221AR/2796886 | 0.66 | 3 | $1.98
2023-03-31 | TMCP0J106MTRF(10uf) | 718-2485-1-ND | https://www.digikey.com/en/products/detail/vishay-sprague/TMCP0J106MTRF/10107417 | 0.34 | 5 | $1.70
2023-03-31 | RMCF0805JT5R10(5.1ohm) | 738-RMCF0805JT5R10CT-ND | https://www.digikey.com/en/products/detail/stackpole-electronics-inc/RMCF0805JT5R10/1712026 | 0.1 | 1 | $0.10
2023-03-31 | MMSZ5231B-7-F | MMSZ5231B-FDICT-ND | https://www.digikey.com/en/products/detail/diodes-incorporated/MMSZ5231B-7-F/755472 | 0.16 | 2 | $0.32
2023-03-31 | REF191GSZ-REEL | REF191GSZ-REELCT-ND | https://www.digikey.com/en/products/detail/analog-devices-inc/REF191GSZ-REEL/994506 | 5.06 | 1 | $5.06
2023-03-31 | TMCP1A105MTRF (1uf) | 718-TMCP1A105MTRFCT-ND | https://www.digikey.com/en/products/detail/vishay-sprague/TMCP1A105MTRF/12617570 | 0.46 | 5 | $2.30
2023-03-31 | RMCF0805FT1K00CT-ND | RMCF0805FT1K00 | https://www.digikey.com/en/products/detail/stackpole-electronics-inc/RMCF0805FT1K00/1760090 | 0.1 | 16 | $1.60
 |  |  | Estimated DigiKey shipping Cost | 16.99 | 1 | $16.99
 | Total DigiKey Cart Link |  | https://www.digikey.com/short/jqw8d2t8
2023-03-31 | 584-LT1990CS8#PBF | LT1990CS8#PBF | https://www.mouser.com/ProductDetail/Analog-Devices/LT1990CS8PBF?qs=ytflclh7QUV8ORz%252BFGLW4A%3D%3D | 4.19 | 16 | $67.04
2023-03-31 | 774-405C11A16M00000 | 405C11A16M00000 | https://www.mouser.com/ProductDetail/774-405C11A16M00000 | 0.95 | 2 | $1.90
2023-03-31 | 80-C0805C475J4RAUTO | C0805C475J4RACAUTO | https://www.mouser.com/ProductDetail/80-C0805C475J4RAUTO | 0.428 | 10 | $4.28
 |  |  | Estimated Mouser shipping Cost | 1 | 7.99 | $7.99
 | Total Mouser Cart Link |  | https://www.mouser.com/ProjectManager/ProjectDetail.aspx?AccessID=b806c8ac93
2023-03-31 | 38-2-0330 | PCB | AdvancedPCB | 66 | 1 | $66.00 | 4 Layer Board W=5.86, H = 4.359
 |  |  |  |  | Order Total Cost: | $243.90
 |  |  |  |  | Spent to date | $611.78
 |  |  |  |  | Budget Remaining | -$219.28
