ajodutola/FuelCellMonitorTeam-ECEN403/PCB_Final_Update/Fuel Cell Monitor Master_BOM.xlsx

Comment | Description | Designator | Footprint | LibRef | Quantity | DesignItemId
5.1ohm resistor |  | *1 | 5.1 ohm resistor | 5.1ohm resistor | 1 | 5.1ohm resistor
=Value | Conn Shrouded Header (4 Sides) HDR 16 POS 2.54mm Solder RA Side Entry Thru-Hole Box | 1 |  | 30316-5002HB | 1 | 30316-5002HB
ADS8344N/1K | IC ADC 16BIT SAR 20SSOP | ADC1, ADC2 | ADS8344 | ADS8344N/1K | 2 | ADS8344N/1K
Value | CAP CER 4.7UF 16V X7R 0805 | C1, C2, C12, C13, C14, C15 | Capacitor_Kemet_0805 | C0805C475J4RACAUTO | 6 | C0805C475J4RACAUTO
Value | Cap Ceramic 0.1uF 16V X7R 5% SMD 0805 125°C Plastic T/R | C3, C4, C10, C11, C16, C17, C85, C89, C90, C91, C92, C93, C94 | Capacitor_Kemet_0805 | C0805C104J4RACTU | 13 | C0805C104J4RACTU
Value | Cap Ceramic 0.1uF 35V X7R 10% SMD 0805 125°C Paper T/R | C5, C6, C8, C9 | Capacitor_Kemet_0805 | C0805C104K6RACTU | 4 | C0805C104K6RACTU
.1 uF (50 V) |  | C7, C19, C20, C22, C23, C24, C25, C26, C27, C28, C29, C30, C31, C32, C33, C34, C35, C36, C37, C38, C39, C40, C41, C42, C43, C44, C45, C46, C47, C48, C49, C50, C51, C52, C53, C54, C55, C56, C57, C58, C59, C60, C61, C62, C63, C64, C65, C66, C67, C68, C69, C70, C73, C75, C78, C79, C82, C84 | .1uF capacitor | .1 uF cap | 58 | .1 uF cap
10 uF (6.3 V) |  | C18, C74, C76, C83 | 10 uF cap | 10 uF cap | 4 | 10 uF cap
1uf (10V) |  | C21 | 1 uF cap | 1uf cap | 1 | 1uf cap
330 uF (35 V) |  | C71, C80 | 330uf cap | 330 uF cap | 2 | 330 uF cap
220 uF (6.3 V) |  | C72, C77, C81 | 220 uf cap | 220 uF capacitor | 3 | 220 uF capacitor
Value | Cap, AEC-Q200, 10PF, 50V, Mlcc, 0805; | C86, C87 | Kemet_10pF_0805 | C0805C100F5GACAUTO | 2 | C0805C100F5GACAUTO
Value | 0805 C 10uF Ceramic Multilayer Capacitor; 25 VDC; +85degC; X5R Dielec; +/-10% | C88 | Capacitor_Kemet_0805 | C0805C106K3PACTU | 1 | C0805C106K3PACTU
405C11A16M00000 | CRYSTAL 16.0000MHZ 10PF SMD | Crystal_1 | XTAL_405C11A16M00000 | 405C11A16M00000 | 1 | 405C11A16M00000
Value | SIMPLE SWITCHE Power Converter 150 KHz 1A Step-Down Voltage egulator 5-DDPAK/TO-263 | DC/DC1 | LM2595s-3.3 | LM2595SX-3.3/NOPB | 1 | LM2595SX-3.3/NOPB
LM2595s-5.0 | SIMPLE SWITCHE Power Converter 150 KHz 1A Step-Down Voltage egulator 5-DDPAK/TO-263 | DC/DC2 | LM2595s-5.0 | LM2595S-5.0/NOPB | 1 | LM2595S-5.0/NOPB
B340AE-13 | Schottky Diode, DO-201, 40V, 3.00A | DIODE1, DIODE3 | B340AE-13 | B340AE-13 | 2 | B340AE-13
Value | Zener diode | DIODE2 | MMSZ5231B-7-F Zener diode | MMSZ5231B-7-F | 1 | MMSZ5231B-7-F
ESP32-WROOM-32D( |  | ESP32 | ESP32 | ESP32-WROOM-32D( | 1 | ESP32-WROOM-32D(
PIC_ESP_Program |  | ESP_Prog | ESP_Program | PIC_ESP_Program | 1 | PIC_ESP_Program
DCP020505U/1K | Miniature, 2W Isolated Unregulated DC/DC Converters 12-SOP -40 to 85 | Isolated DC/DC1 | DCP020505U | DCP020505U/1K | 1 | DCP020505U/1K
PJ-037A | 2.0 mm Center Pin, 2.5 A, Right Angle, Through Hole, Dc Power Jack Connector | J1 | CUI_PJ-037A | PJ-037A | 1 | PJ-037A
100 uH |  | L1, L2 | 100uH inductor | 100 uH inductor | 2 | 100 uH inductor
LT1990 |  | LT1, LT2, LT3, LT4, LT5, LT6, LT7, LT8, LT9, LT10, LT11, LT12, LT13, LT14, LT15, LT16 | LT1990ACS8 | LT1990 | 16 | LT1990
Value | OPTOISO 2.5KV 4CH OPEN COLL 16SO | OPIS1, OPIS2 | Opto_Isolator_ACSL6400_50TE | ACSL-6400-50TE | 2 | ACSL-6400-50TE
PIC32MX470F512H- |  | PIC1 | Quad64_2 | PIC32MX470F512H- | 1 | PIC32MX470F512H-
PIC_Program_Module |  | PIC_PROG_1 | PIC_32_POD | PIC_Program_Module | 1 | PIC_Program_Module
Value | Res Thin Film 0805 402 Ohm 0.1% 1/8W ±25ppm/°C Molded SMD Paper T/R | R1, R2, R3, R4 | LowR_Yageo | RT0805BRD07402RL | 4 | RT0805BRD07402RL
Value | Res Thick Film 0805 1K Ohm 1% 0.125W(1/8W) ±100ppm/C Pad SMD T/R | R5, R6, R7, R8, R9, R14 | Resistor_YAGEO_0805 | RC0805FR-071KP | 6 | RC0805FR-071KP
Value | RES 10K OHM 1% 1/8W 0805 | R10, R12, R13, R15, R32 | Resistor_YAGEO_0805 | RC0805FR-1010KL | 5 | RC0805FR-1010KL
Value | 825 Ohms ±1% 0.125W, 1/8W Chip Resistor 0805 (2012 Metric) Moisture Resistant Thick Film | R11 | Resistor_YAGEO_0805 | RC0805FR-07825RL | 1 | RC0805FR-07825RL
1kohm resistor |  | R16, R17, R18, R19, R20, R21, R22, R23, R24, R25, R26, R27, R28, R29, R30, R31 | 1kohm resistor | 1kohm resistor | 16 | 1kohm resistor
REF191GSZ-REEL | Precision Micropower, Low Dropout Voltage Reference, 2.048 V Output, 2.3 to 15 V Supply, Industrial, 8-pin SOIC (R-8), Reel | U1 | ADI-R-8_N | REF191GSZ-REEL | 1 | REF191GSZ-REEL
Value | IC VREF SERIES ADJ 0.2% SOT23-5 | Vref_1 | VRef | MAX6037AAUKADJ+T | 1 | MAX6037AAUKADJ+T
