ajodutola/FuelCellMonitorTeam-ECEN403/PCB_Final_Update/Fuel Cell Monitor Master.pdf

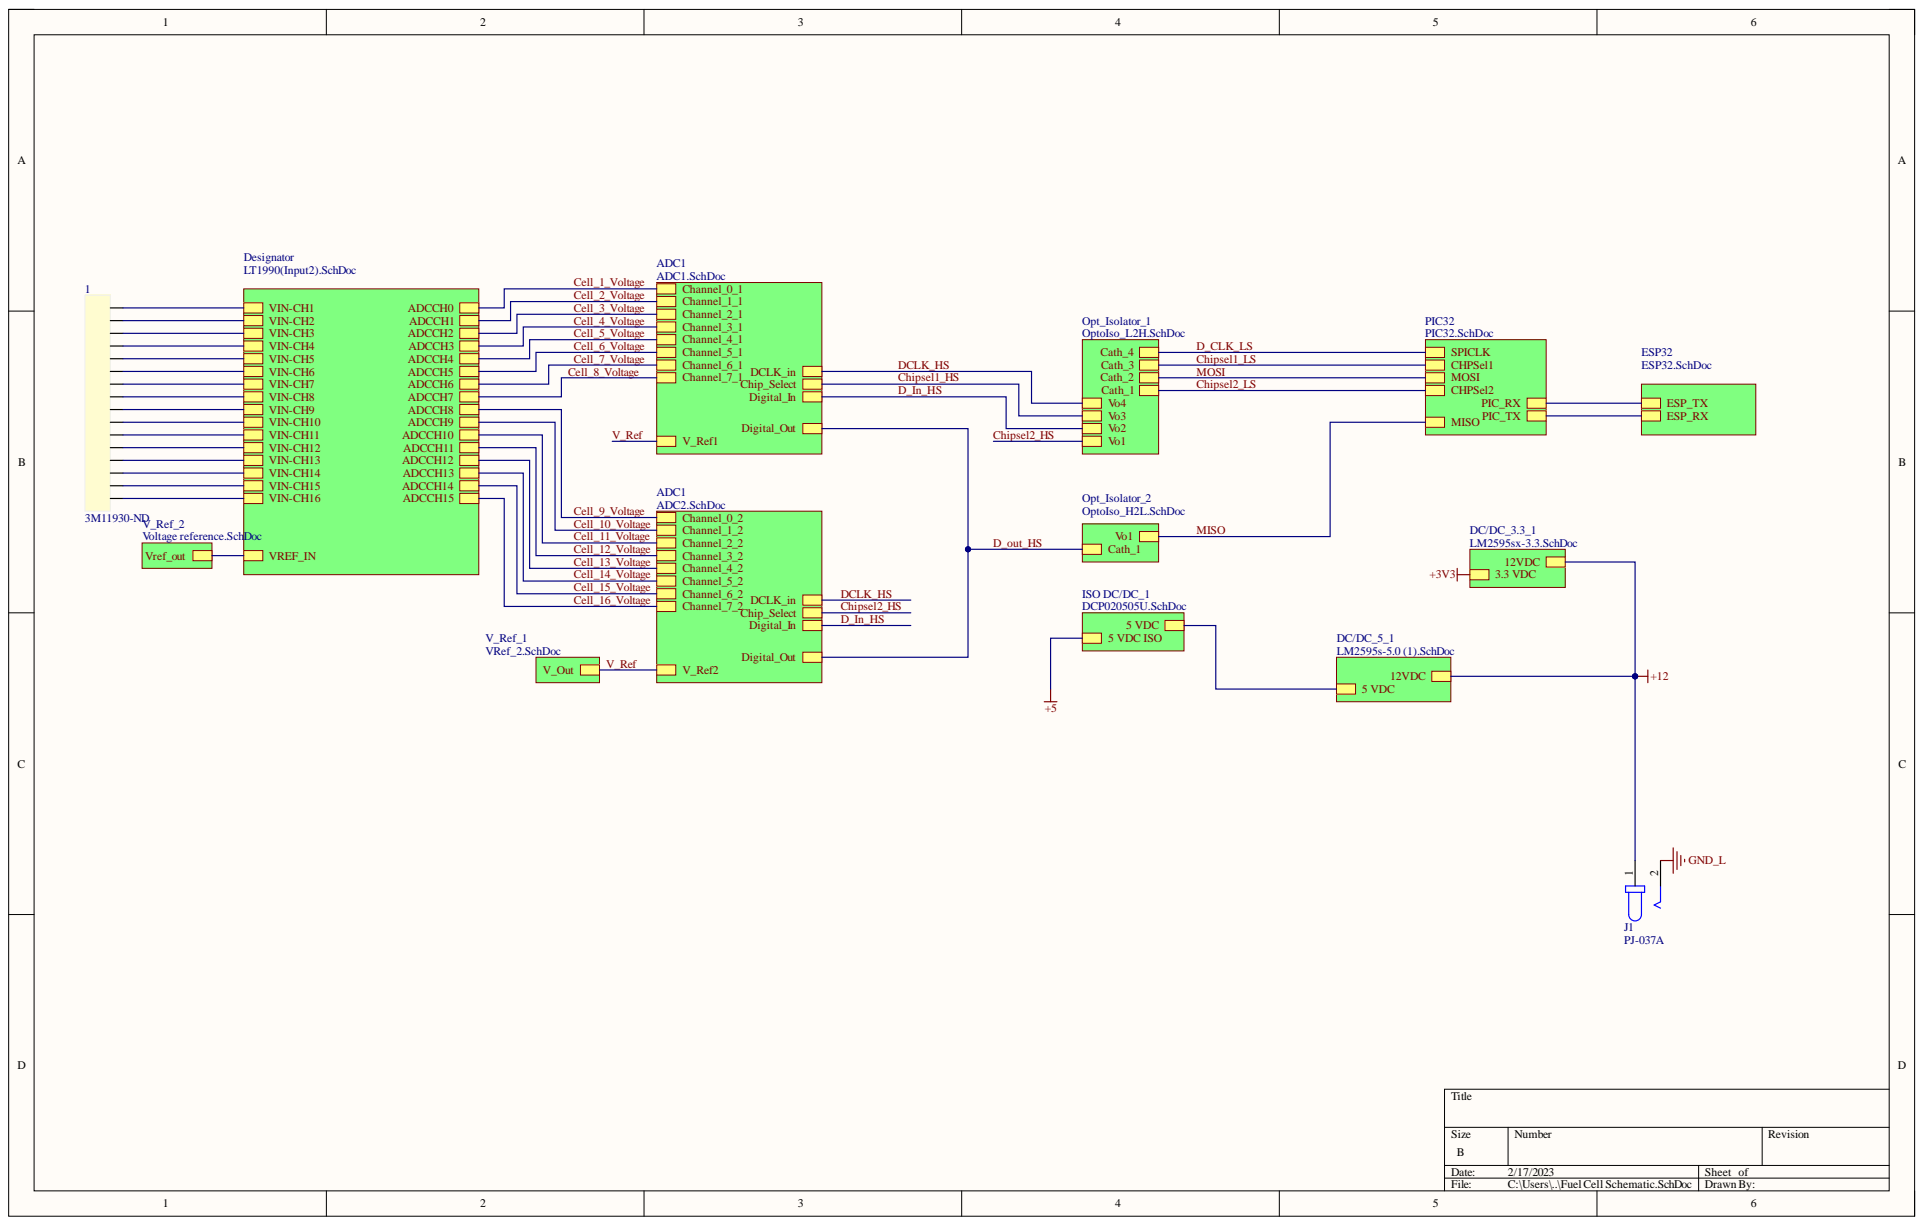
[picture p120: page 1]

Cel l_4_Vol t ag e
Cel l_5_Vol t ag e
Cel l_6_Vol t ag e

Si z e | Num b er | Revi s i on

e : 2/17/ 20 2 3 | Sheet of
Fi l e : C : \U ser s \..\Fuel Cel l Schemat ic.S chDo c | D rawn By:

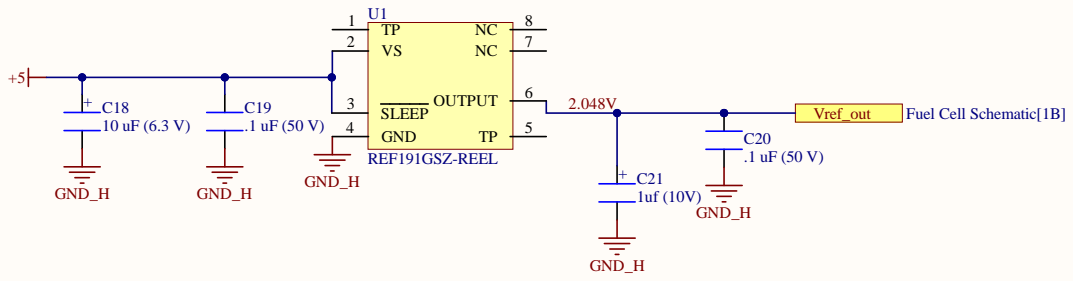
[picture p121: page 2]

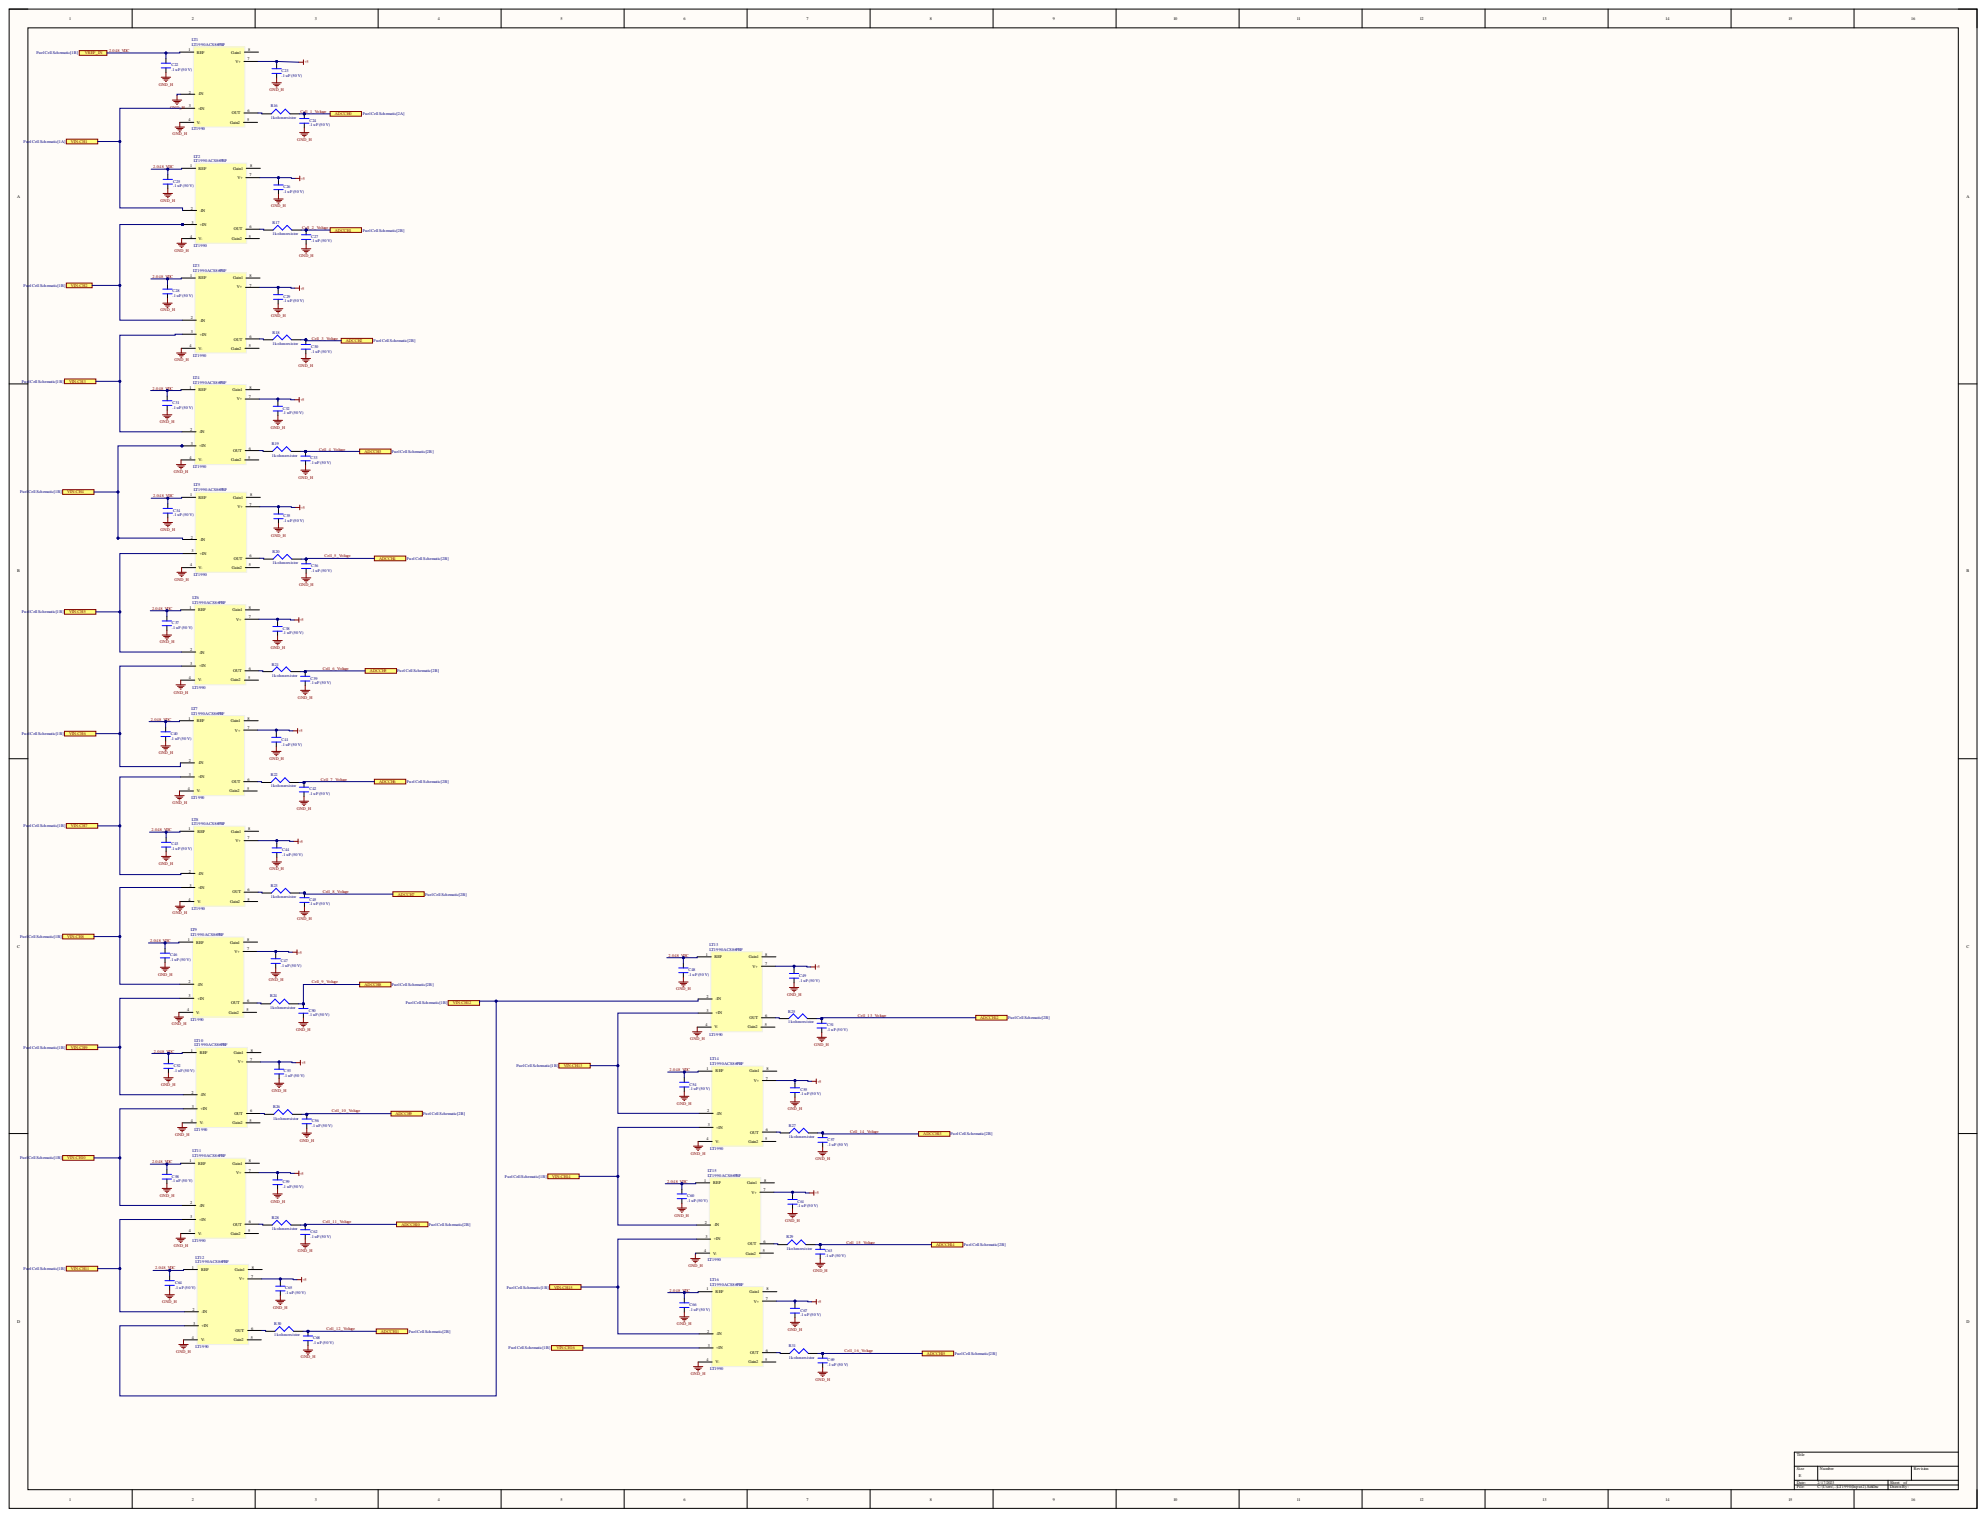
[picture p122: page 3]

C37 .1 uF (50 V) GND_H | REF 1 V+ -IN 2 OUT | 7 6

V- 4 | GND_H | +IN 3

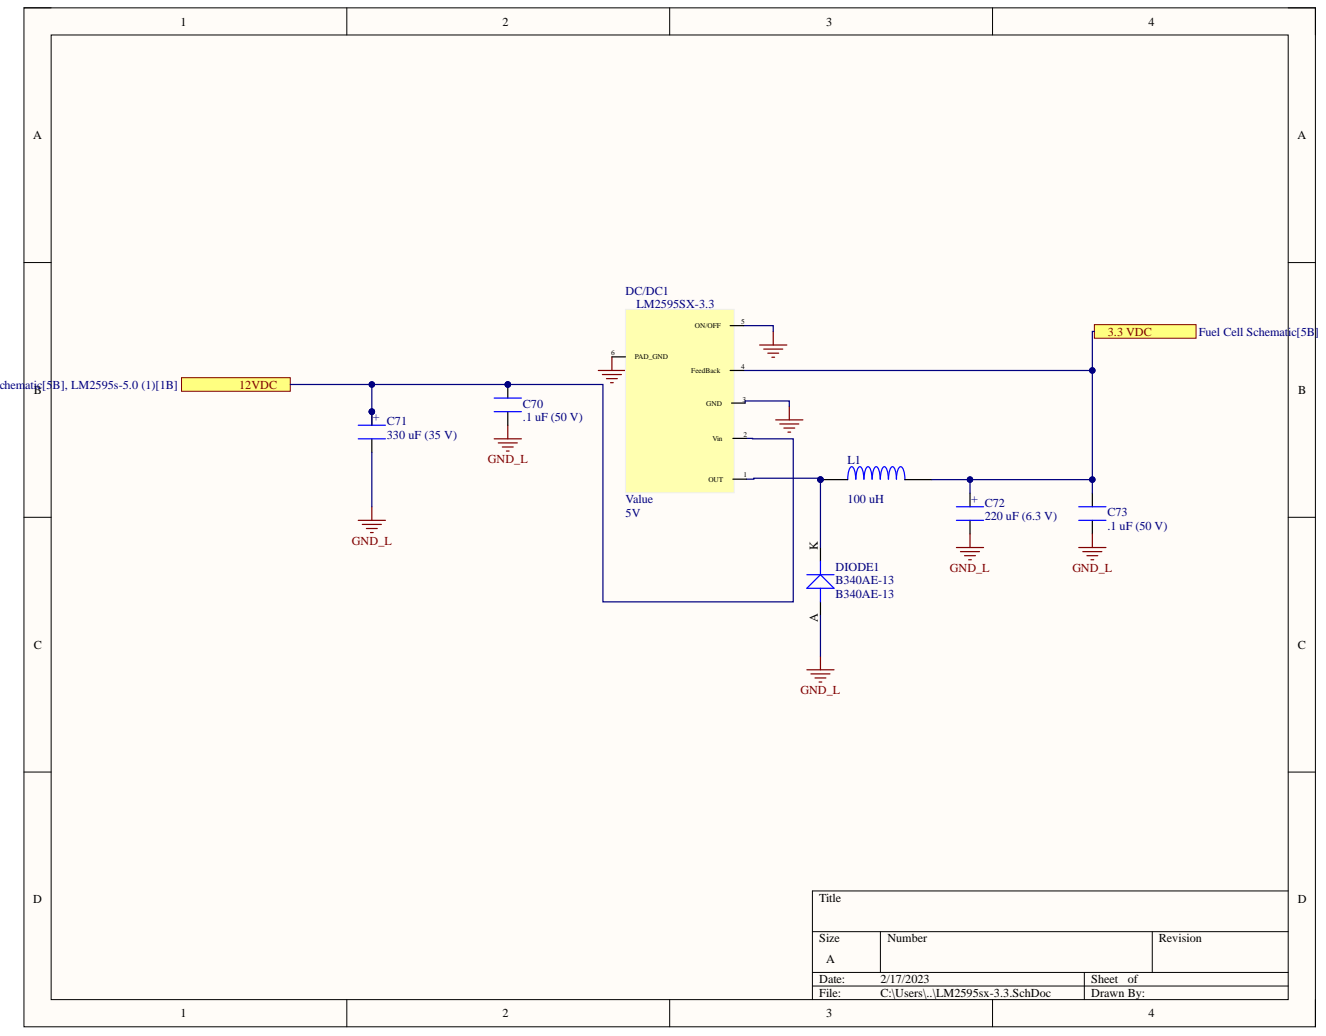
[picture p123: page 4]

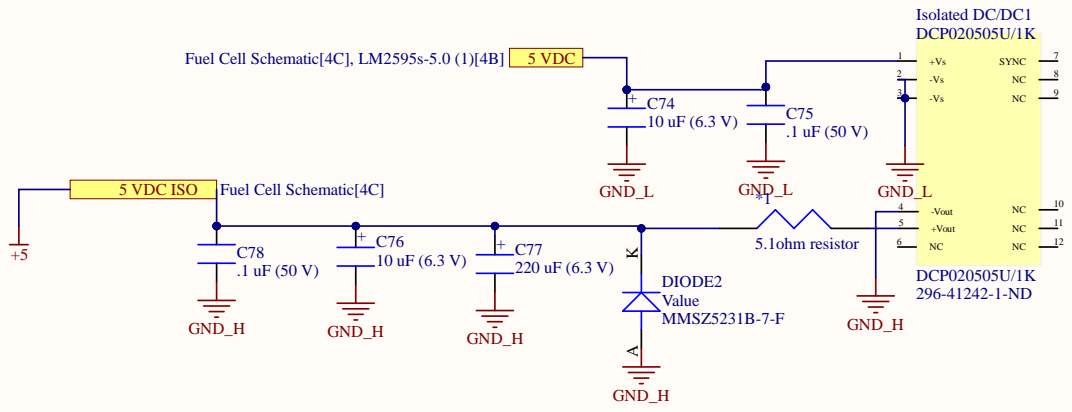
[picture p124: page 5]

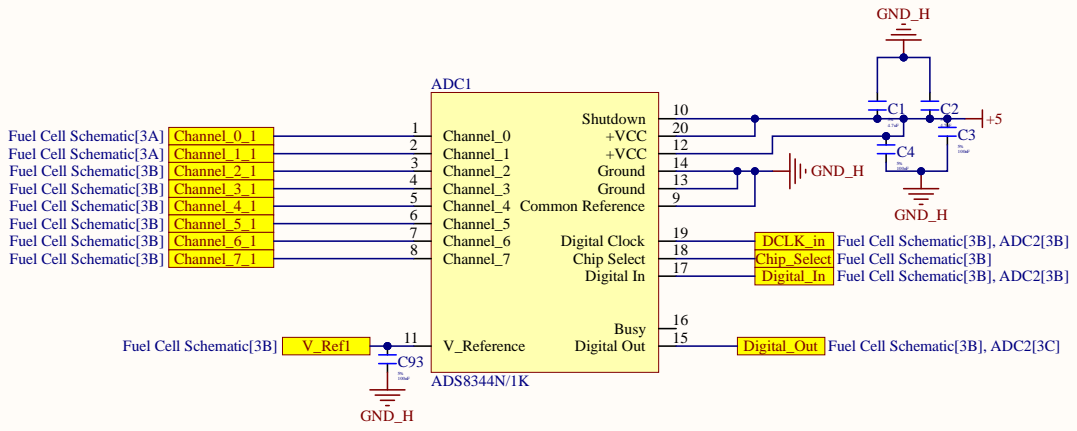
[picture p125: page 6]

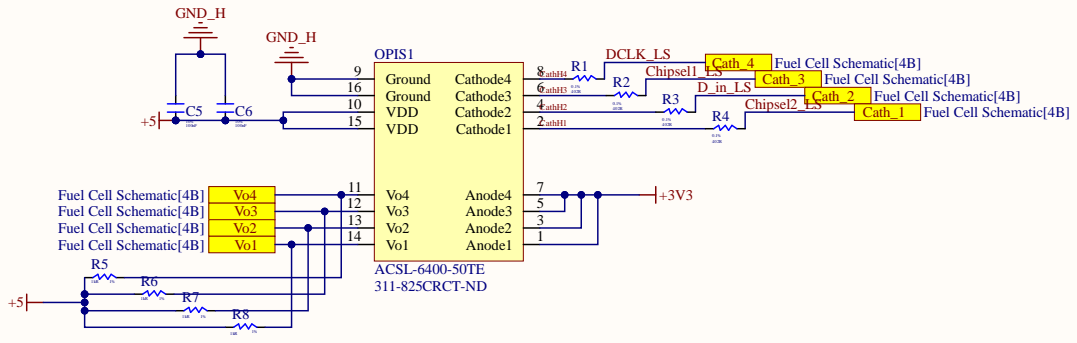
[picture p126: page 7]

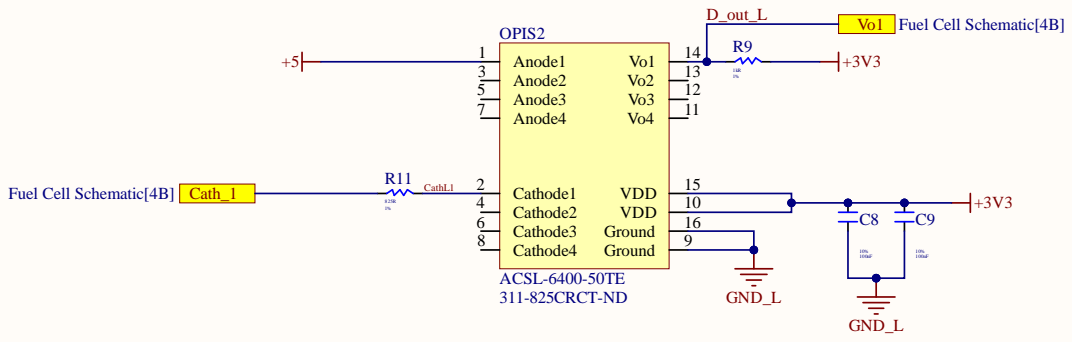
[picture p127: page 8]

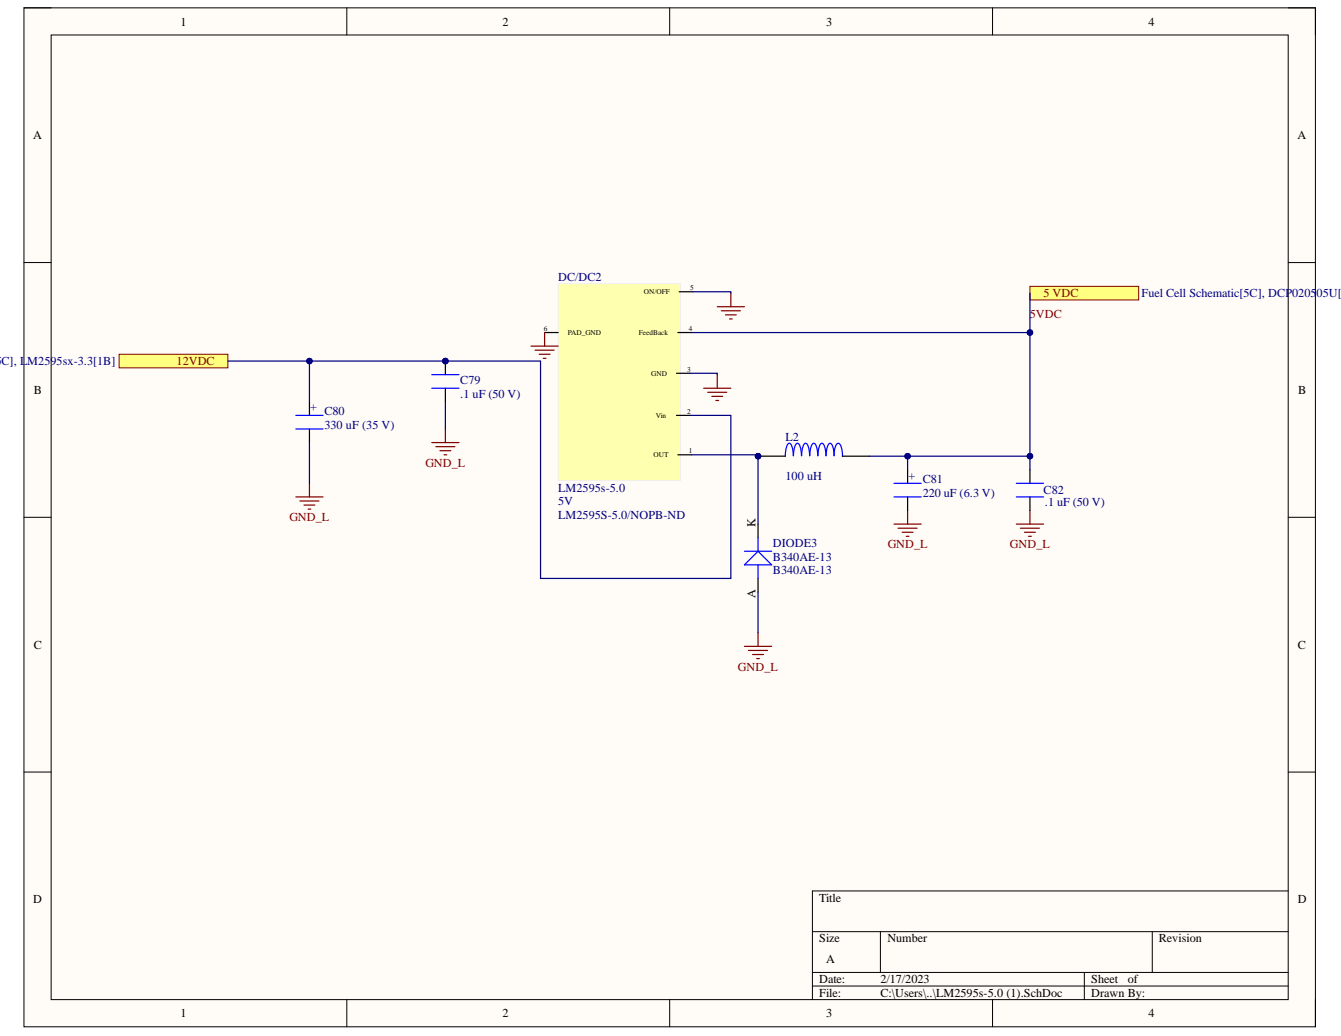
[picture p128: page 9]

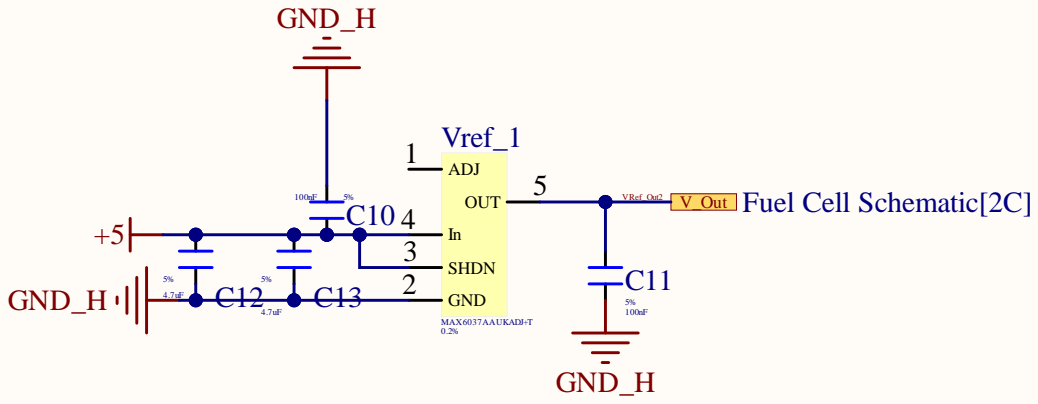
[picture p129: page 10]

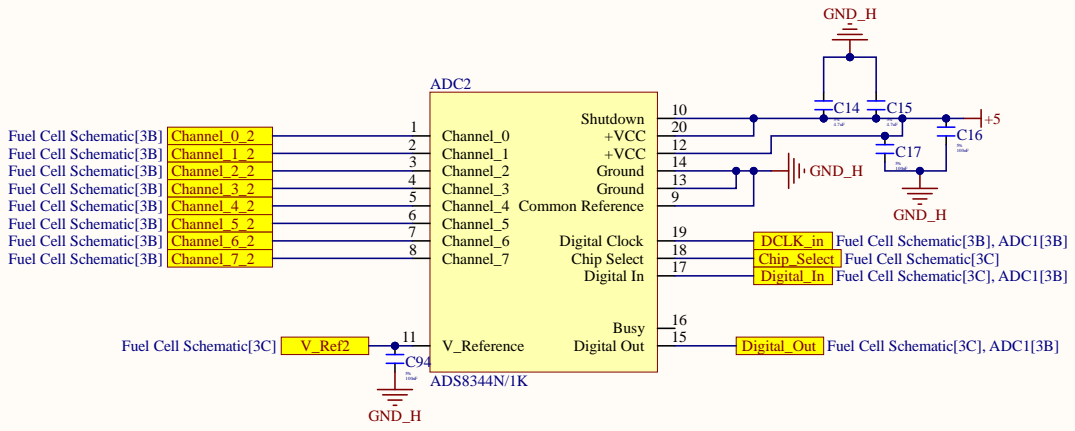
[picture p130: page 11]

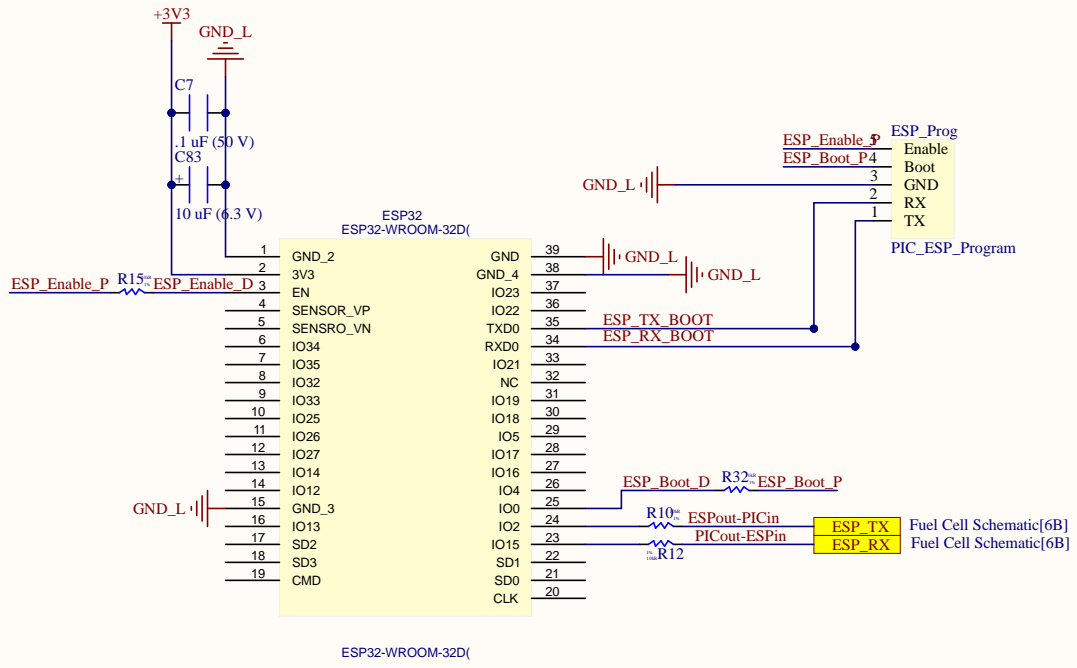
[picture p131: page 12]

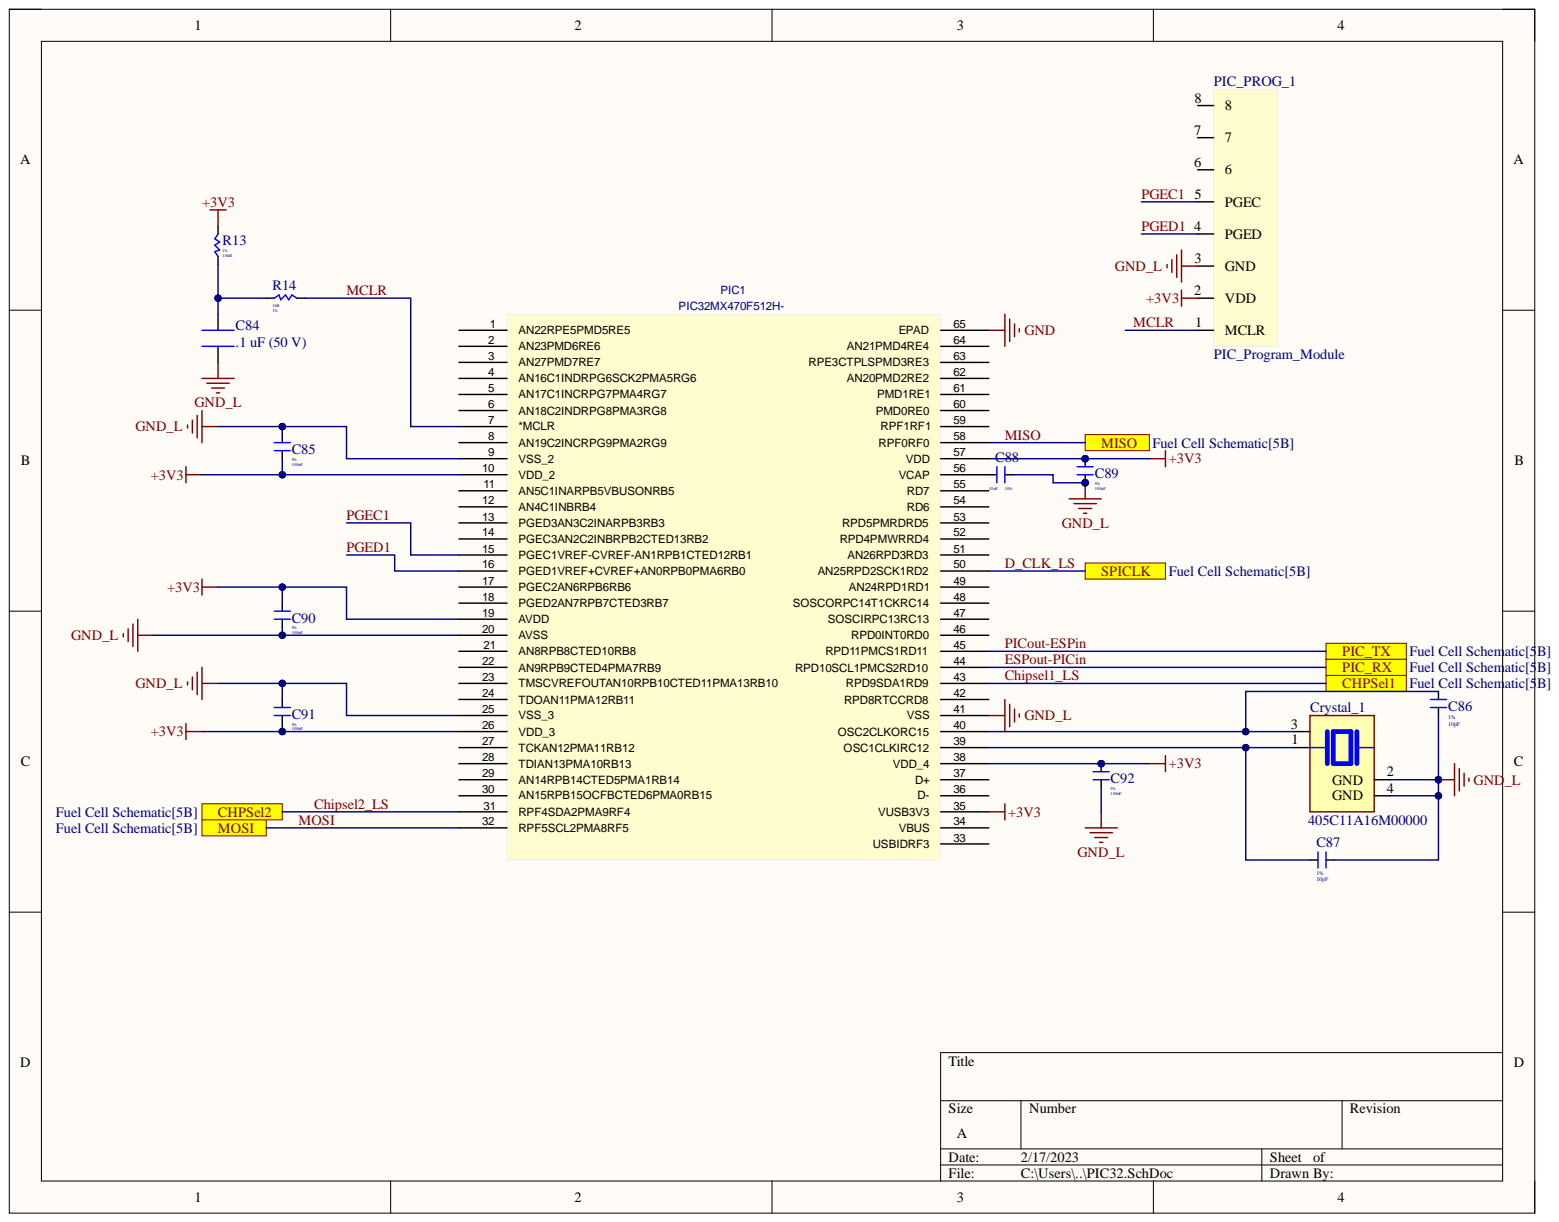
[picture p132: page 13]

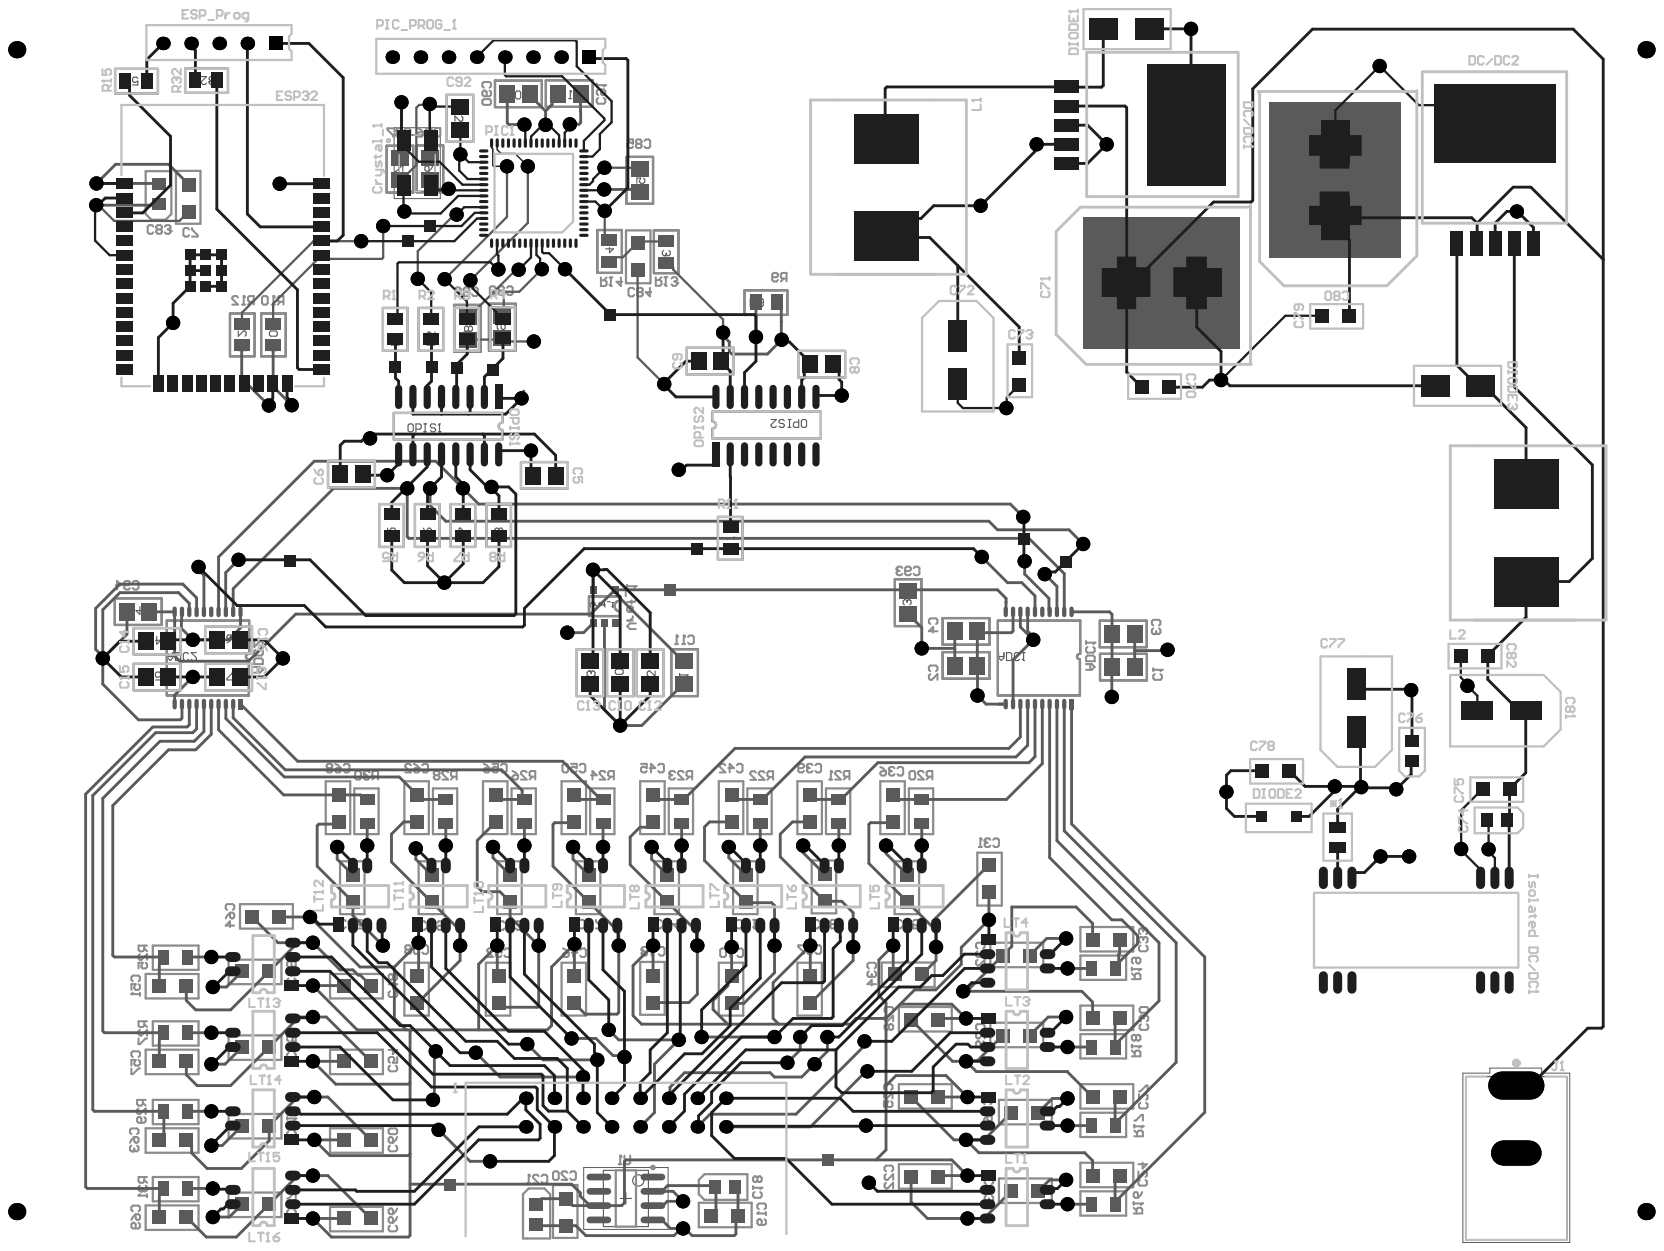
[picture p133: page 14]
