ajodutola/FuelCellMonitorTeam-ECEN403/(list of files, drawings)

Other design files:
All_Russ_Docs/403 iso sim.ms14
All_Russ_Docs/ADC_OptoIso_Simulation.ms14
PCB_Final_Update/ADC1.SchDoc
PCB_Final_Update/ADC2.SchDoc
PCB_Final_Update/ESP32.SchDoc
PCB_Final_Update/FCM_Integrated.PcbDoc
PCB_Final_Update/FCM_Integrated_old.PcbDoc
PCB_Final_Update/FCM_Integrated_other Old.PcbDoc
PCB_Final_Update/Fuel Cell Monitor Master.PrjPcb
PCB_Final_Update/Fuel Cell Schematic.SchDoc
PCB_Final_Update/LT1990.SchDoc
PCB_Final_Update/OptoIso_H2L.SchDoc
PCB_Final_Update/OptoIso_L2H.SchDoc
PCB_Final_Update/PcbLib1.PcbLib
PCB_Final_Update/PIC32.SchDoc
PCB_Final_Update/Schlib1.SchLib
PCB_Final_Update/Vref_1.SchDoc
PCB_Final_Update/VRef_2.SchDoc
